wzh201998/ECCE_2026_Design-and-Implementation-of-A-Hybrid-EMI-Filter-for-11kW-OBC/Figure/Filter_Hardware.png

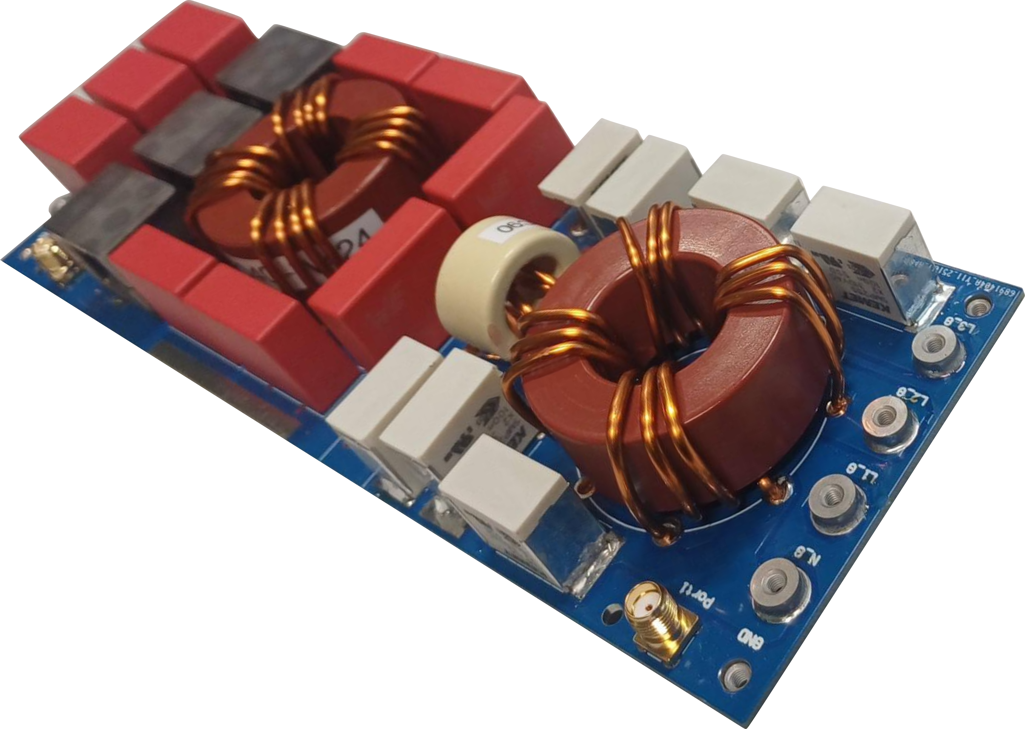
Figure/Filter_Hardware.png
