wzh201998/ECCE_2026_Design-and-Implementation-of-A-Hybrid-EMI-Filter-for-11kW-OBC/Experiment/Thermal/FLIR0065.jpg

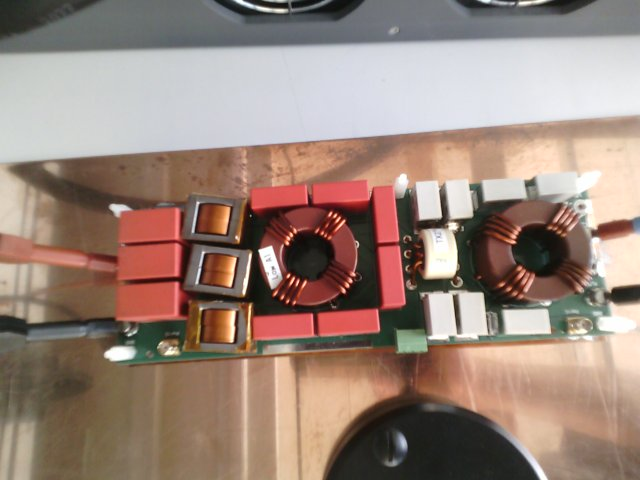
Experiment/Thermal/FLIR0065.jpg
