wzh201998/ECCE_2026_Design-and-Implementation-of-A-Hybrid-EMI-Filter-for-11kW-OBC/README.md

# ECCE_2026_Design-and-Implementation-of-A-Hybrid-EMI-Filter-for-11kW-OBC
ECCE 2026 paper "Design and Implementation of A Hybrid EMI Filter for 11kW OBC"
