wzh201998/ECCE_2026_Design-and-Implementation-of-A-Hybrid-EMI-Filter-for-11kW-OBC/Presentation/380_Hybrid EMI Filter for 11kW OBC.pptx

## Hybrid EMI Filter for 11kW Onboard Charger

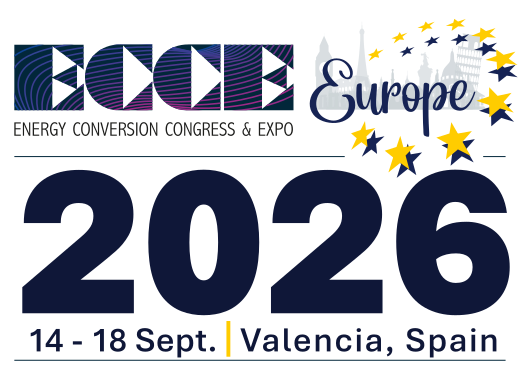
[picture p3: figure]

Weihao Zhao
Stefan Mollov
Michael Hartmann

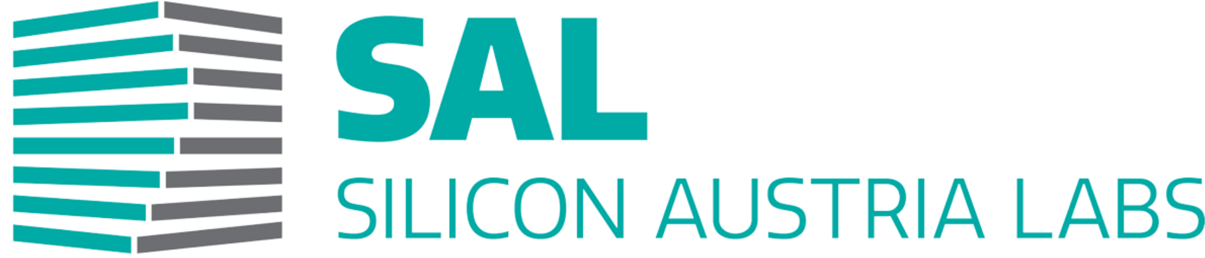
[picture p4: figure]

## Slide 2

Tiny Power Box Project

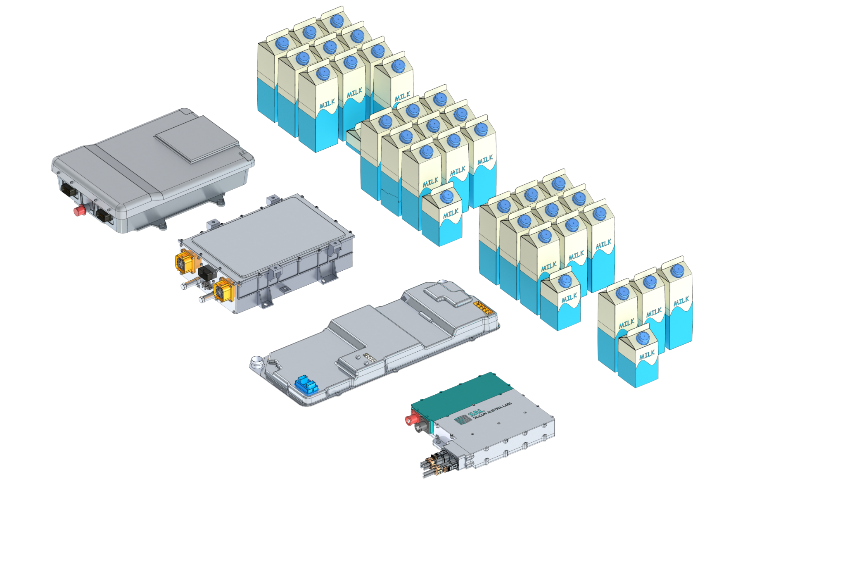
[picture p5: figure]

*Volume indicator

High-Power Density OBC
- 3Φ (11kW) /1Φ (7.2kW)
- IEC-61851 Compliant
- Low-Profile

2.0

## Slide 3

3-Φ/1-Φ Input EV Chargers

High-Power Density OBC
- 3Φ (11kW) /1Φ (7.2kW)
- IEC-61851 Compliant
- Low-Profile

Topology1

IEC-61851-21-1: Conductive charging systems for electric vehicles - Part 21-1: EMC requirements for on-board chargers for AC/DC powered electric vehicles

## Slide 4

Design Challenges

- 3Φ/1Φ Input Compatible

3Φ Mode

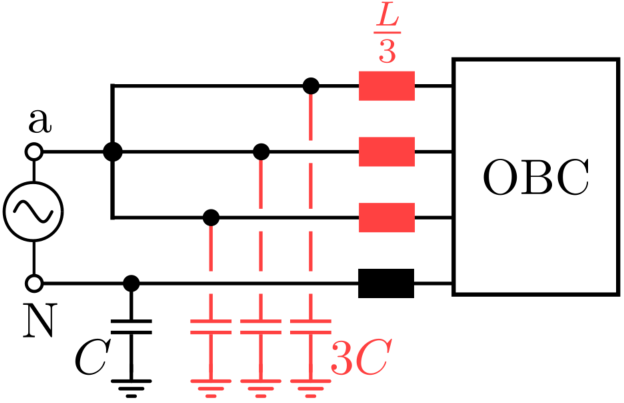
[picture p7: figure]

1Φ Mode

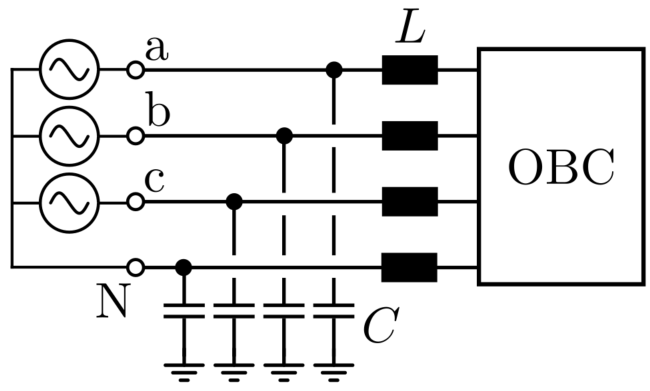
[picture p8: figure]

## Slide 5

Design Challenges

- 3Φ/1Φ Input Compatible
- Low Leakage Current[1]

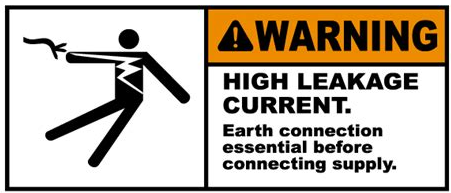
[picture p9: figure]
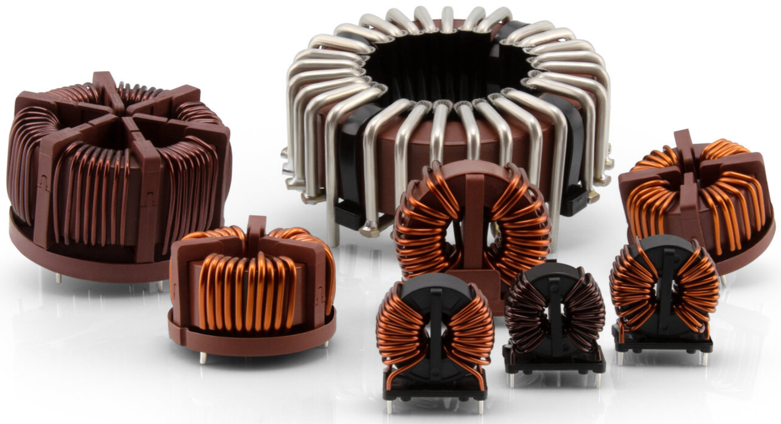
[picture p10: figure]

1. IEC 61851-1, Electric Vehicle Conductive Charging System-Part I General Requirements

## Slide 6

Design Challenges

- 3Φ/1Φ Input Compatible
- Low Leakage Current[1]
- Strict Volume Restriction

Z

Y

X

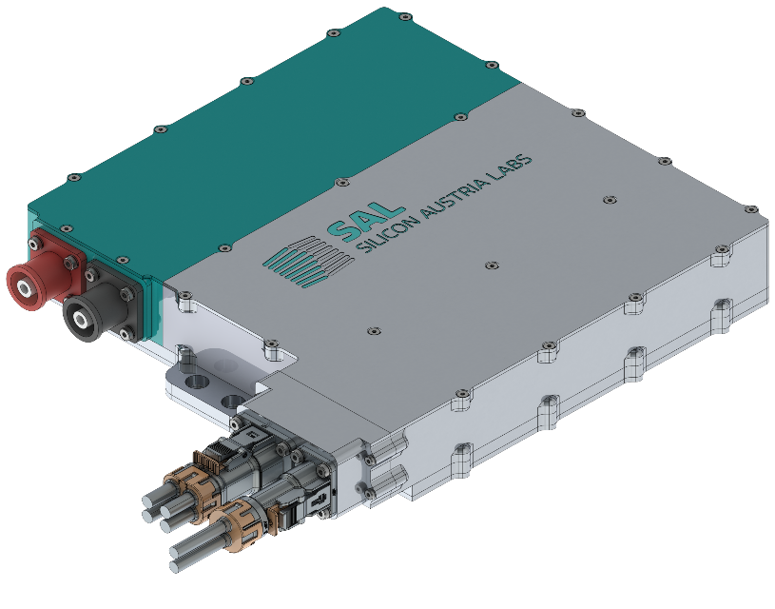
[picture p11: figure]

250mm

270mm

50mm

1. IEC 61851-1, Electric Vehicle Conductive Charging System-Part I General Requirements

## Slide 7

Solution

Passive EMI Filter

Hybrid EMI Filter

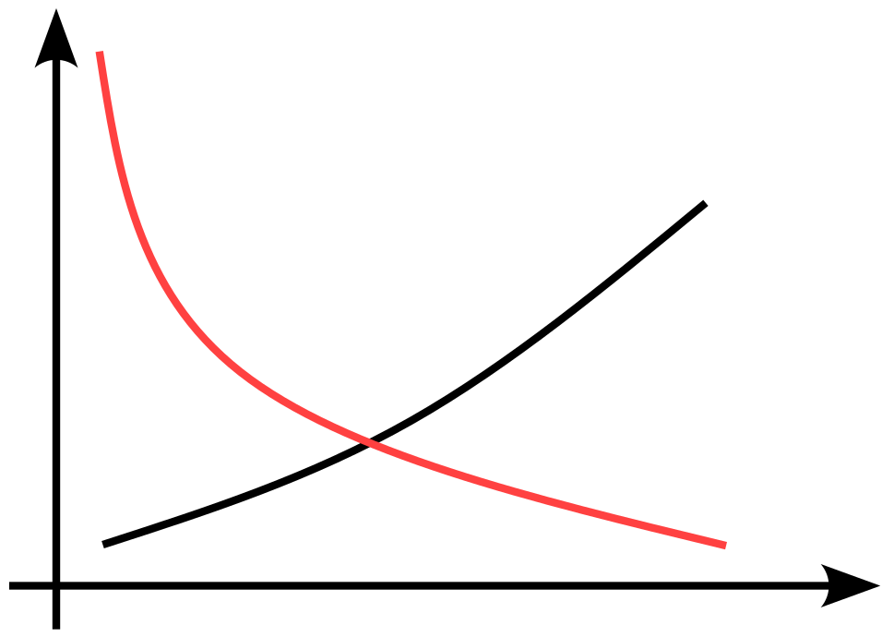
[picture p12: figure]
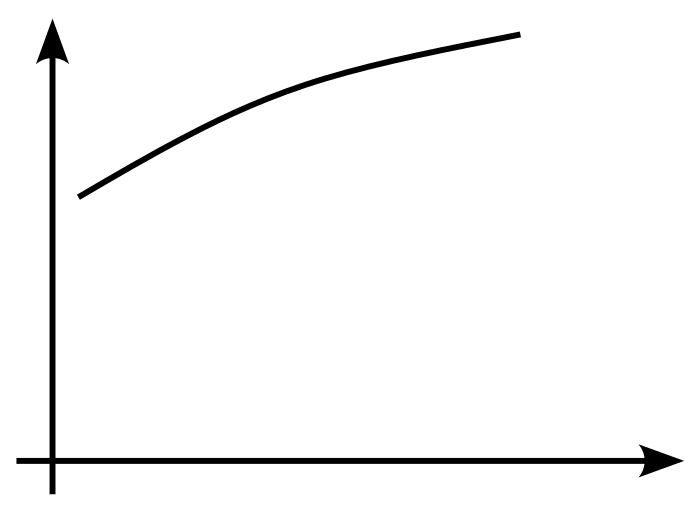
[picture p13: figure]

Passive Filter

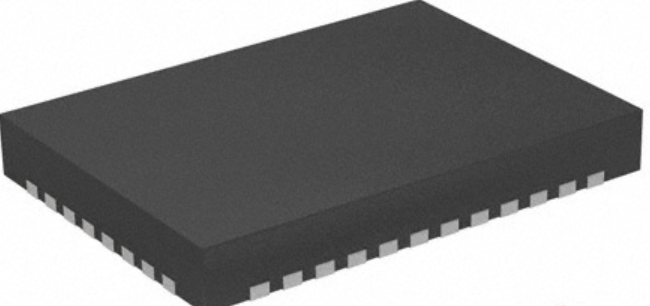
[picture p14: figure]

Active Filter

Attenuation (dB)

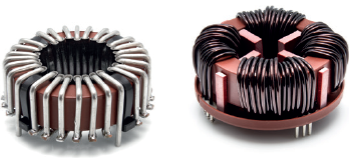
[picture p15: figure]

Attenuation (dB)

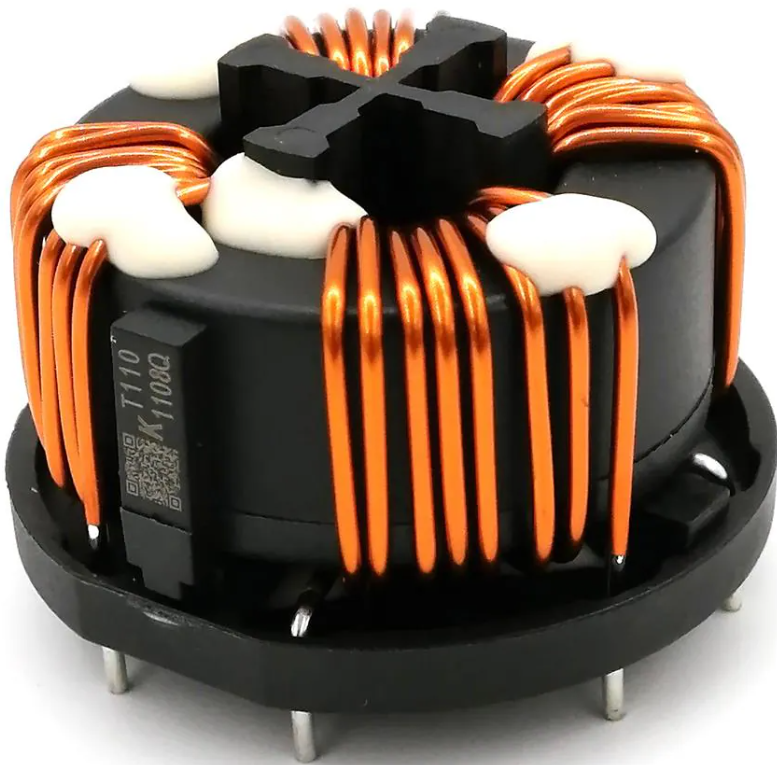
[picture p16: figure]

Passive Filter

Frequency

Frequency

https://vacuumschmelze.com/products/inductive-components-and-cores/amorphous-and-nanocrystalline-cores

## Slide 8

Active EMI Filter

  - Measurement
  - Processing
  - Compensation

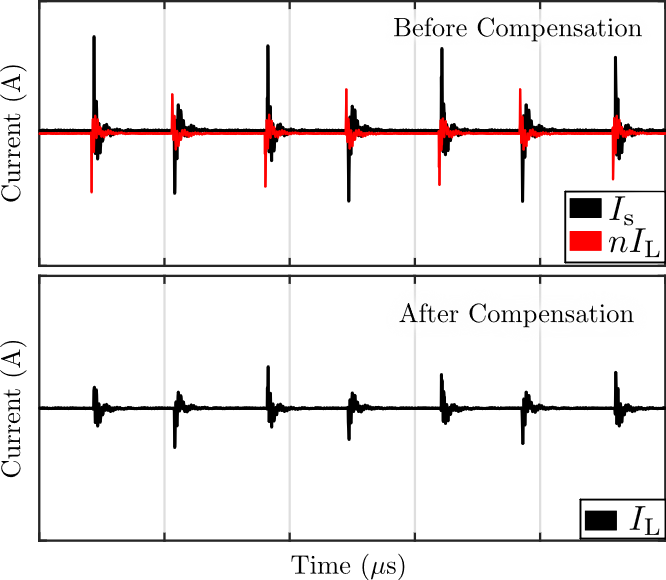
[picture p17: figure]

LISN

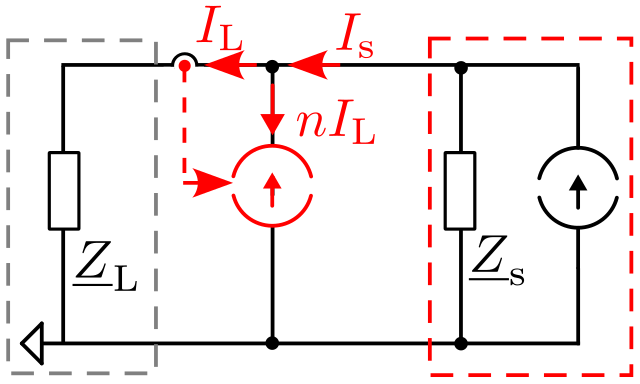
[picture p18: figure]

DUT

W. Zhao and M. Hartmann, "Design and Implementation of An Active Common Mode EMI Filter for LV Automotive Applications," PCIM 2025, Germany.

## Slide 9

Design Consideration

- Output Capability
- Stability
- Adaptability

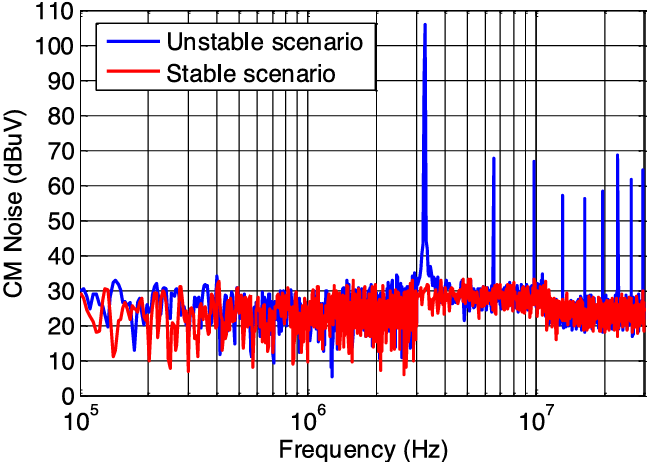
[picture p19: figure]
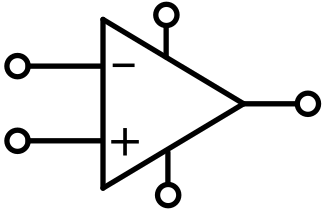
[picture p20: figure]

Y. Chu, S. Wang and Q. Wang, "Modeling and Stability Analysis of Active/Hybrid Common-Mode EMI Filters for DC/DC Power Converters," IEEE TPEL, 2016.

## Slide 10

Design Consideration

- Output Capability
- Stability
- Adaptability

~μA

~mA

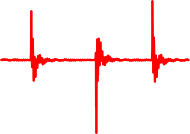
[picture p21: figure]

~ A

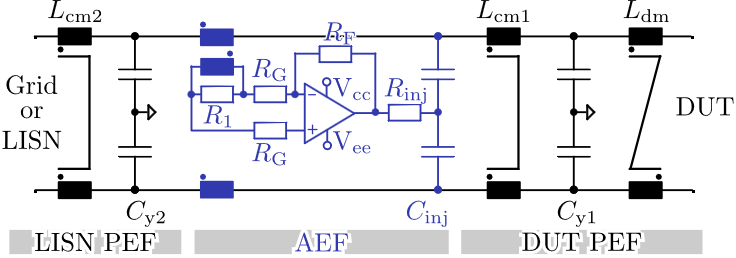
[picture p22: figure]

## Slide 11

11kW Hybrid Filter (3Φ Mode)

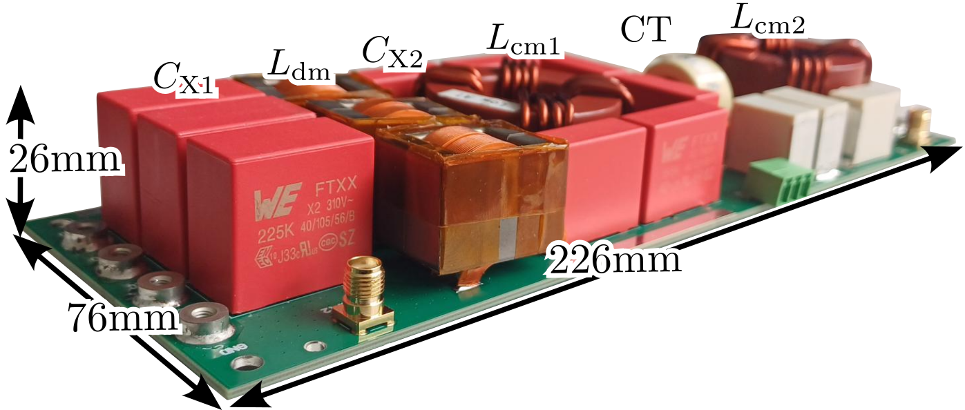
[picture p23: figure]

- 3Φ/1Φ Input Compatible
- 1.3mA Leakage Current

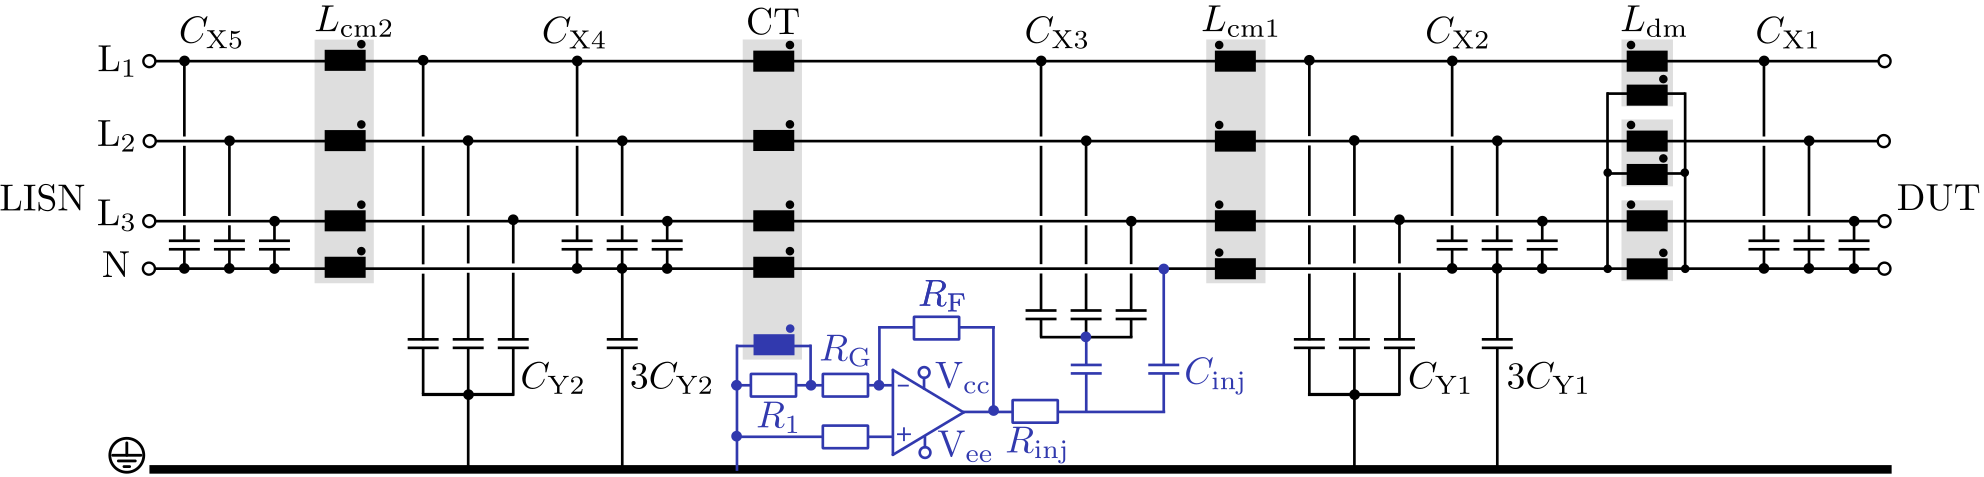
[picture p24: figure]

## Slide 12

11kW Hybrid Filter (1Φ Mode)

- 3Φ/1Φ Input Compatible
- 1.3mA Leakage Current

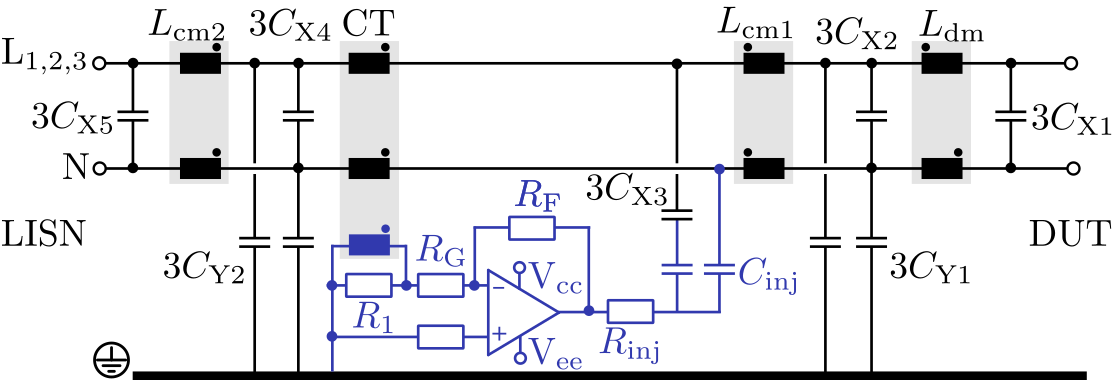
[picture p25: figure]

## Slide 13

Insertion Loss Measurement

- Effective 30kHz-2MHz
- 45dB improvement @450kHz

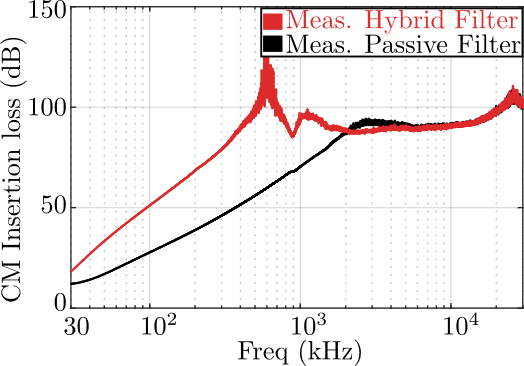
[picture p26: figure]
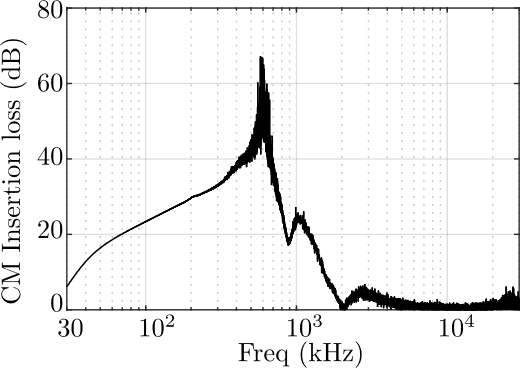
[picture p27: figure]

Active Filter

## Slide 14

Benchmark Passive Filter

- Lcm1 reduced by 90%
- Lcm2 reduced by 75%

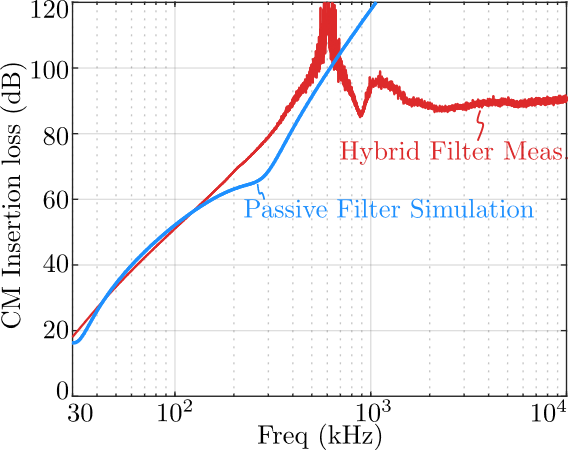
[picture p28: figure]
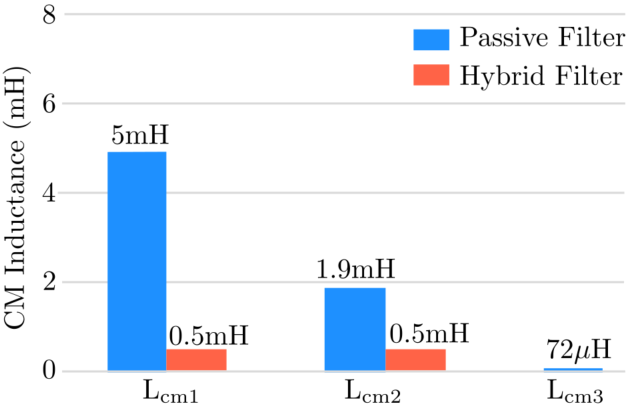
[picture p29: figure]

## Slide 15

Conductive Emission Measurement

- 50dB attenuation required

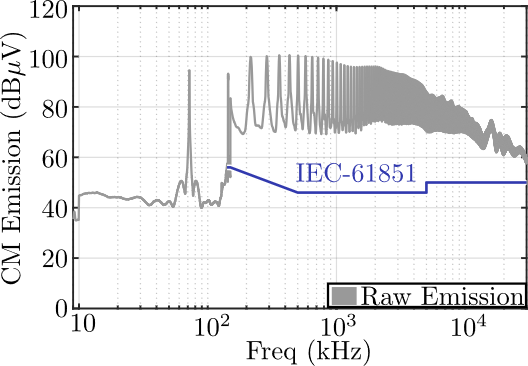
[picture p30: figure]

Copper Plane

LISN

DUT

EMI Receiver

## Slide 16

Conductive Emission Measurement

- 10dB violation in 150kHz-600kHz
- HF Noise is reduced

Copper Plane

LISN

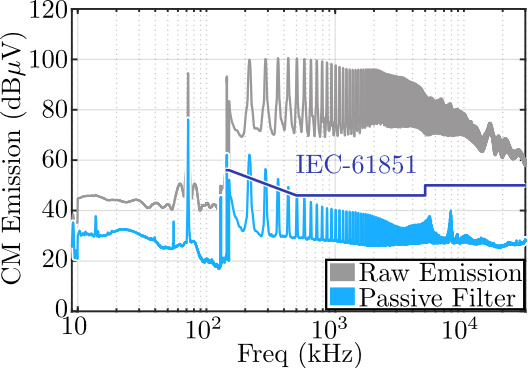
[picture p31: figure]

PEF

DUT

EMI Receiver

*PEF: Passive EMI Filter

## Slide 17

Conductive Emission Measurement

- Effective 9kHz-1MHz
- 27dB@150kHz

Copper Plane

LISN

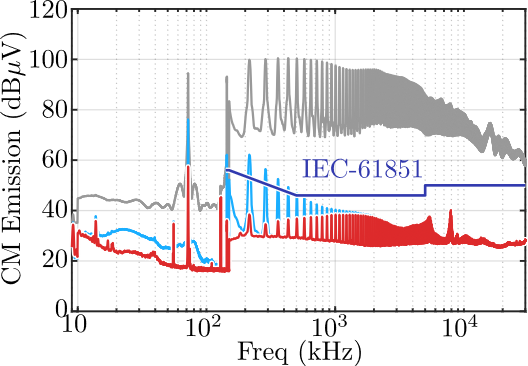
[picture p32: figure]

HEF

DUT

EMI Receiver

*HEF: Hybrid EMI Filter

## Slide 18

Conclusion

- Hybrid EMI Filter New Design Option
  - Volume/Weight Reduction
  - Higher Attenuation
  - Higher Power Density

Passive Filter

Hybrid Filter

https://vacuumschmelze.com/products/inductive-components-and-cores/amorphous-and-nanocrystalline-cores

## Slide 19

Questions

## Slide 20

Active EMI Filter Design

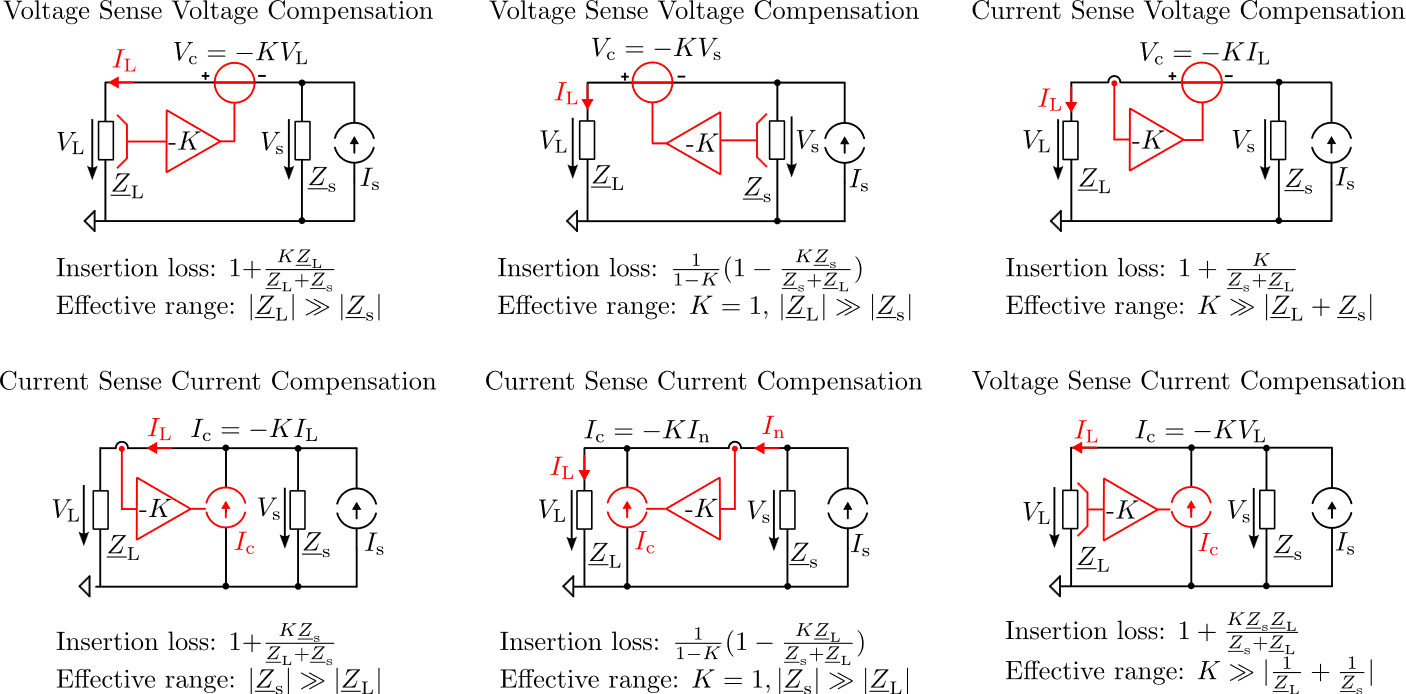
[picture p33: figure]

Notes: Top row, the compensation signal is voltage
Bottome row, the compensation signal is current

## Slide 21

Conclusion

3Φ /1Φ Comptible 11kW Hybrid EMI Filter
  - Inductance reduced by 90%
  - 27dB attenuation improvement @150kHz
  - Effective from 9kHz-1MHz
  - Low-Profile Filter Design (26mm)

Passive Filter

Hybrid Filter

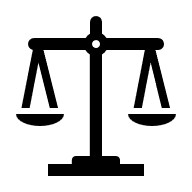
[picture p34: figure]
Scales of justice with solid fill

## Slide 22

Insertion Loss Measurement

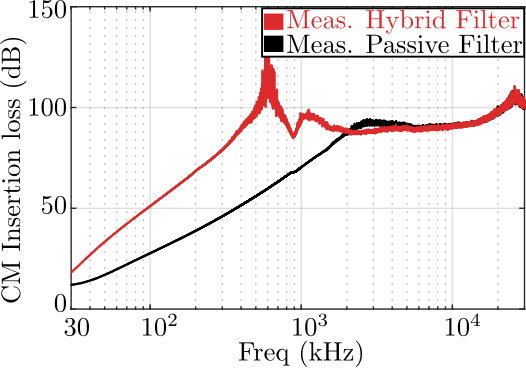
[picture p35: figure]

Vector Network Anlyzer

Hybrid Filter

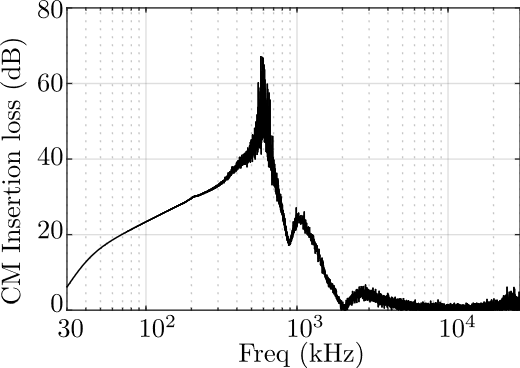
[picture p36: figure]
