wzh201998/ECCE_2026_Design-and-Implementation-of-A-Hybrid-EMI-Filter-for-11kW-OBC/Experiment/Meas_HEF_Spectrum/200v4a ldm1.BMP

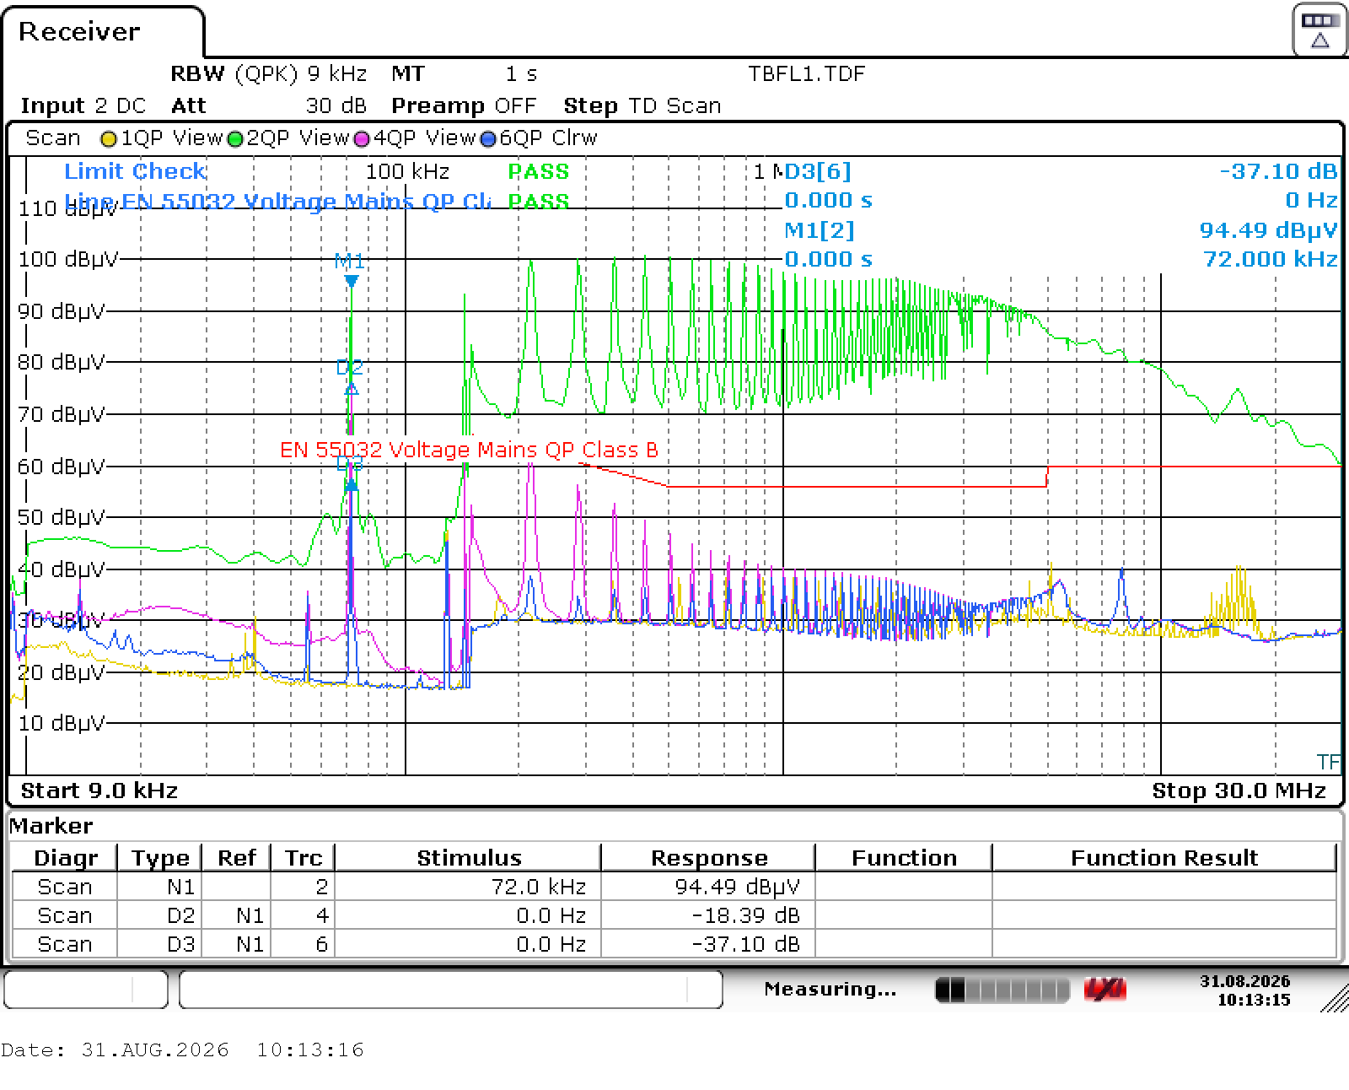
Experiment/Meas_HEF_Spectrum/200v4a ldm1.BMP
