wzh201998/ECCE_2026_Design-and-Implementation-of-A-Hybrid-EMI-Filter-for-11kW-OBC/Experiment/Cost_Analysis.xlsx

Capacitor
 | Part number | Units | Price(euro/1k)
CX1 | 890334026034 | 3 | 1.78376 | 5.35128 | 38.03209
CX2 | 890334026030CS | 3 | 1.455 | 4.365
CX3 | SMP255FC6100MD32TR32 | 7 | 2.52676 | 17.68732
Cy1 | DK1E3EA102M86RBH01 | 3 | 1.10723 | 3.32169
Cy2 | 8853522140011 | 6 | 0.73068 | 4.38408
Cinj | 8853522140011 | 4 | 0.73068 | 2.92272
Inductor
Lcm1 |  | 1 | 5.75 | 5.75 | 29.57452
Lcm2 |  | 1 | 5.75 | 5.75
CT | Tx22/14/!3 3C90 | 1 | 0.67452 | 0.67452
LDM |  | 6 | 2.9 | 17.4
AEF
OP-amp | LM7171 | 1 | 2.89229 | 2.89229 | 4.908292
power | TEC 3-2415 | 1 | 1.086002 | 1.086002
LDO | TPS7B8450QWDRBRQ1 | 1 | 0.93 | 0.93
PCB |  | 1 | 1.6 | 1.6
 |  |  |  | 74.114902
