wzh201998/ECCE_2026_Design-and-Implementation-of-A-Hybrid-EMI-Filter-for-11kW-OBC/Experiment/CM Choke/Large_AL/CM_choke_high_AL.pdf

# DPG10 Power Choke Tester

D.U.T.: | CM inductor-high AL

### Inspector:

Date: | 3/24/2026 3:32:22 PM
Parameters: | 1 A / 10 V / 1000 (35) µs
Resistance: | 2.22 mOhm

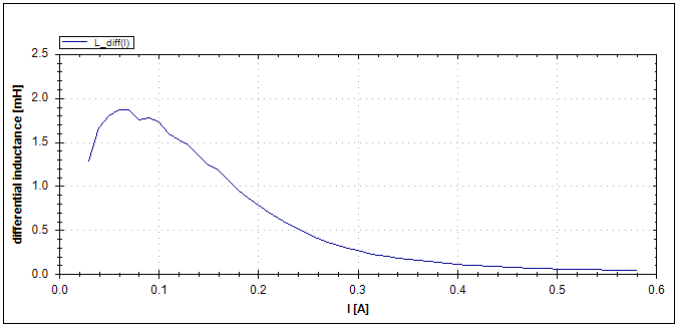
[picture p39: figure]

0.03 | 1.29
0.04 | 1.66
0.05 | 1.79
0.06 | 1.86
0.07 | 1.86
0.08 | 1.76
0.09 | 1.77
0.10 | 1.73
0.11 | 1.59
0.12 | 1.53
0.13 | 1.46
0.14 | 1.36
0.15 | 1.24
0.16 | 1.18
0.17 | 1.07
0.18 | 0.949
0.19 | 0.859
0.20 | 0.781
0.21 | 0.699
0.22 | 0.629
0.23 | 0.567
0.24 | 0.508
0.25 | 0.452
0.26 | 0.404
0.27 | 0.364
0.28 | 0.327
0.29 | 0.294
0.30 | 0.266
0.31 | 0.240
0.32 | 0.217
0.33 | 0.198
0.34 | 0.180
0.35 | 0.165
0.36 | 0.151
0.37 | 0.139
0.38 | 0.128
0.39 | 0.118
0.40 | 0.109
0.41 | 0.101
0.42 | 0.0945
0.43 | 0.0881
0.44 | 0.0824
0.45 | 0.0772
0.46 | 0.0725
0.47 | 0.0683
0.48 | 0.0644
0.49 | 0.0609
0.50 | 0.0576
0.51 | 0.0547
0.52 | 0.0519
0.53 | 0.0494
0.54 | 0.0471
0.55 | 0.0450
0.56 | 0.0430
0.57 | 0.0412
0.58 | 0.0395
