wzh201998/ECCE_2026_Design-and-Implementation-of-A-Hybrid-EMI-Filter-for-11kW-OBC/Experiment/CM Choke/Small_AL/CM_choke_low_AL.pdf

# DPG10 Power Choke Tester

D.U.T.: | CM inductor-high AL

### Inspector:

Date: | 3/24/2026 3:29:14 PM
Parameters: | 1 A / 10 V / 1000 (31) µs
Resistance: | 2.22 mOhm

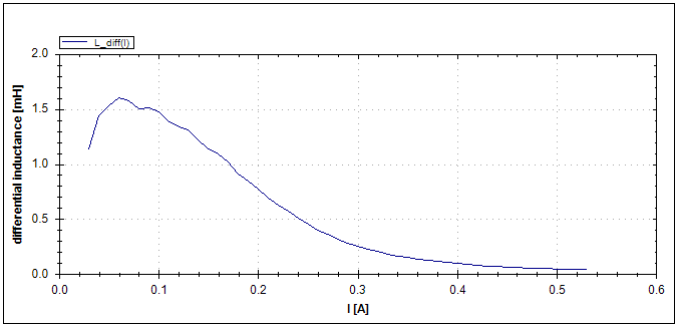
[picture p40: figure]

0.03 | 1.13
0.04 | 1.43
0.05 | 1.53
0.06 | 1.60
0.07 | 1.57
0.08 | 1.50
0.09 | 1.51
0.10 | 1.47
0.11 | 1.38
0.12 | 1.34
0.13 | 1.31
0.14 | 1.22
0.15 | 1.14
0.16 | 1.09
0.17 | 1.02
0.18 | 0.910
0.19 | 0.841
0.20 | 0.770
0.21 | 0.692
0.22 | 0.628
0.23 | 0.567
0.24 | 0.506
0.25 | 0.449
0.26 | 0.400
0.27 | 0.357
0.28 | 0.318
0.29 | 0.284
0.30 | 0.253
0.31 | 0.226
0.32 | 0.203
0.33 | 0.182
0.34 | 0.164
0.35 | 0.148
0.36 | 0.134
0.37 | 0.122
0.38 | 0.111
0.39 | 0.102
0.40 | 0.0930
0.41 | 0.0854
0.42 | 0.0787
0.43 | 0.0726
0.44 | 0.0673
0.45 | 0.0625
0.46 | 0.0582
0.47 | 0.0542
0.48 | 0.0507
0.49 | 0.0476
0.50 | 0.0447
0.51 | 0.0421
0.52 | 0.0398
0.53 | 0.0377
