wzh201998/ECCE_2026_Design-and-Implementation-of-A-Hybrid-EMI-Filter-for-11kW-OBC/Experiment/DM Inductor/Non_Coupled/DM_choke_non-coupled.pdf

# DPG10 Power Choke Tester

D.U.T.: | DM inductor-non coupled

### Inspector:

Date: | 3/24/2026 3:21:52 PM
Parameters: | 45 A / 10 V / 1000 (491) µs
Resistance: | 16.73 mOhm

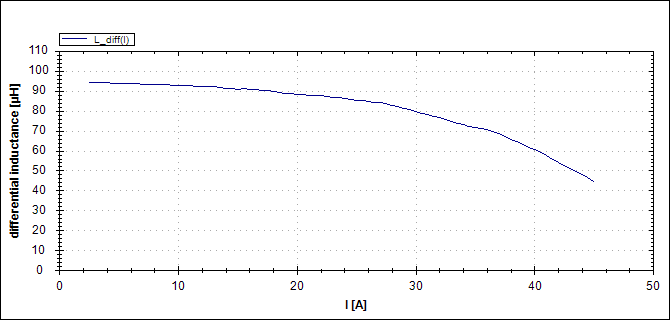
[picture p41: figure]

2.5 | 94.3
3.0 | 94.3
3.5 | 94.2
4.0 | 94.0
4.5 | 93.8
5.0 | 93.8
5.5 | 93.7
6.0 | 93.6
6.5 | 93.5
7.0 | 93.3
7.5 | 93.2
8.0 | 93.1
8.5 | 93.1
9.0 | 92.9
9.5 | 92.8
10.0 | 92.6
12.0 | 92.4
12.5 | 92.3
13.0 | 92.0
13.5 | 91.6
14.0 | 91.4
14.5 | 91.1
15.0 | 90.8
15.5 | 90.9
16.0 | 90.7
16.5 | 90.4
17.0 | 90.3
17.5 | 89.9
18.0 | 89.6
18.5 | 89.1
19.0 | 88.8
19.5 | 88.5
20.0 | 88.2
22.0 | 87.6
22.5 | 87.2
23.0 | 86.8
23.5 | 86.4
24.0 | 86.0
24.5 | 85.6
25.0 | 85.3
25.5 | 85.0
26.0 | 84.6
26.5 | 84.2
27.0 | 83.9
27.5 | 83.4
28.0 | 82.8
28.5 | 82.2
29.0 | 81.3
29.5 | 80.5
30.0 | 79.6
32.0 | 76.3
32.5 | 75.4
33.0 | 74.6
33.5 | 73.7
34.0 | 72.9
34.5 | 72.3
35.0 | 71.7
35.5 | 71.2
36.0 | 70.5
36.5 | 69.5
37.0 | 68.5
37.5 | 67.2
38.0 | 65.7
38.5 | 64.4
39.0 | 63.1
39.5 | 61.7
40.0 | 60.3
42.0 | 54.0
42.5 | 52.6
43.0 | 51.1
43.5 | 49.7
44.0 | 48.1
44.5 | 46.4
45.0 | 44.7
