wzh201998/ECCE_2026_Design-and-Implementation-of-A-Hybrid-EMI-Filter-for-11kW-OBC/Experiment/Insertion loss loop gain/loop_gain/LG_ZS-330pF_ZL_51ohm_RG_750_RF_330k.csv

! CMT | S5085 | 19027456 | 23.4.5/2
! Date: 5/5/2026 2:59:57 PM
! Stimulus(Hz) | S11(dB) | S21(dB) | S12(dB) | S22(dB) | S11(°) | S21(°) | S12(°) | S22(°)
9.00000000000E+03 | -1.15671814502E+00 | +1.87810815036E+00 | -3.32906641653E+01 | -3.68205466421E+00 | -3.84646780565E-01 | -6.38274167568E+01 | -1.17244611590E+02 | +1.42699971579E+02
9.00486835309E+03 | -1.12403581887E+00 | +1.99332080703E+00 | -3.31044346941E+01 | -3.69673923098E+00 | -5.13304897399E-01 | -6.41689890204E+01 | -1.19335589129E+02 | +1.43102283692E+02
9.00973933961E+03 | -1.07488799270E+00 | +2.06344917996E+00 | -3.34300378882E+01 | -3.76819387032E+00 | -3.76913345922E-01 | -6.37054117137E+01 | -1.20028874012E+02 | +1.42287006208E+02
9.01461296098E+03 | -1.21046187635E+00 | +1.92543281933E+00 | -3.28513662634E+01 | -3.59605288747E+00 | -6.28664895041E-01 | -6.47866442460E+01 | -1.31429012305E+02 | +1.42729907884E+02
9.01948921863E+03 | -1.20620292065E+00 | +1.90259607407E+00 | -3.14552883834E+01 | -3.67307805779E+00 | -5.94756830358E-01 | -6.43047218437E+01 | -1.17773229050E+02 | +1.43114495418E+02
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
