wzh201998/ECCE_2026_Design-and-Implementation-of-A-Hybrid-EMI-Filter-for-11kW-OBC/Experiment/Insertion loss loop gain/loop_gain/LG_ZS-330pF_ZL_51ohm_RG_750_RF_330k5.csv

! CMT | S5085 | 19027456 | 23.4.5/2
! Date: 5/5/2026 3:19:08 PM
! Stimulus(Hz) | S11(dB) | S21(dB) | S12(dB) | S22(dB) | S11(°) | S21(°) | S12(°) | S22(°)
9.00000000000E+03 | -1.16299261923E+00 | +2.12440108780E+00 | -5.05985279097E+01 | -3.97004784317E+00 | +9.59268277828E-02 | -6.35660774952E+01 | -1.24056308393E+02 | +1.40884515646E+02
9.00486835309E+03 | -1.15570165043E+00 | +2.12535143606E+00 | -4.94974490676E+01 | -3.95918776834E+00 | +3.45443943252E-01 | -6.33629180502E+01 | -1.10757747710E+02 | +1.40799848604E+02
9.00973933961E+03 | -1.15739405081E+00 | +2.13471309024E+00 | -4.84651830921E+01 | -3.97483042737E+00 | +3.13496101804E-01 | -6.32808011098E+01 | -1.23852575224E+02 | +1.40942857125E+02
9.01461296098E+03 | -1.19134033066E+00 | +2.11616762808E+00 | -4.94539242612E+01 | -3.97927985951E+00 | +4.48773737656E-01 | -6.33594766356E+01 | -1.11658414418E+02 | +1.40902847237E+02
9.01948921863E+03 | -1.18577257986E+00 | +2.12461317161E+00 | -5.03067275681E+01 | -3.95722743840E+00 | +2.11713205886E-01 | -6.36633047683E+01 | -1.26357148172E+02 | +1.40852617524E+02
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
