wzh201998/ECCE_2026_Design-and-Implementation-of-A-Hybrid-EMI-Filter-for-11kW-OBC/Experiment/CM Choke/Large_AL/CM_CHOKE_HIGH_AL.CSV

!Keysight Technologies | E4990A | MY54302543 | A.03.06
!Date: Tue Mar 24 14:52:03 2026
BEGIN CH1_DATA
DCV(V) | +1.851e-004 | DCI(A) | -2.556e-006
Frequency(Hz) | |Z|(Ohm)-data | theta-z(deg)-data | Ls(H)-data | Rs(Ohm)-data
+1.00000000000e+003 | +1.31805928802e+001 | +8.57486233890e+001 | +2.09198433187e-003 | +9.77109649249e-001
+1.00733600000e+003 | +1.32726217445e+001 | +8.57630723490e+001 | +2.09128860919e-003 | +9.80594037826e-001
+1.01472600000e+003 | +1.33675650828e+001 | +8.57518557284e+001 | +2.09087861714e-003 | +9.90218299571e-001
+1.02217100000e+003 | +1.34637157109e+001 | +8.57383547727e+001 | +2.09054281316e-003 | +1.00050456570e+000
+1.02967000000e+003 | +1.35607170275e+001 | +8.57242600873e+001 | +2.09023111554e-003 | +1.01103951205e+000
+1.03722400000e+003 | +1.36586767097e+001 | +8.57067681808e+001 | +2.08994977663e-003 | +1.02250126532e+000
+1.04483300000e+003 | +1.37575608270e+001 | +8.56898759566e+001 | +2.08970369568e-003 | +1.03394846817e+000
+1.05249800000e+003 | +1.38566941615e+001 | +8.56728935816e+001 | +2.08938648615e-003 | +1.04549426679e+000
+1.06022000000e+003 | +1.39560745159e+001 | +8.56559932008e+001 | +2.08899790394e-003 | +1.05709736800e+000
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
