wzh201998/ECCE_2026_Design-and-Implementation-of-A-Hybrid-EMI-Filter-for-11kW-OBC/Experiment/CM Choke/Small_AL/CM choke_low_AL.csv

Version=3.7.0.8
Date=3/24/2026 3:29:14 PM
Type=CM inductor-high AL
Inspector=
Remark=
IMax [A]=1
UMax [V]=10
TMax [µs]=1000
FrequencyCorrection [Hz]=0
Stackfactor [%]=0
P-Factor for L-values (diff-Method)=0
P-Factor for LSUdt-values (diff-Method)=0
P-Factor for SUdt-values (diff-Method)=0
P-Factor for L-values (amp-Method)=0
P-Factor for LSUdt-values (amp-Method)=0
P-Factor for SUdt-values (amp-Method)=0
P-Factor for L-values (3~-Method)=0
P-Factor for L-values (3~-diff-Method)=0
MeasCount=1
LowLimitI_diff=
UppLimitI_diff=
LowLimitI_amp=
UppLimitI_amp=
LowLimitSUdt_diff=
UppLimitSUdt_diff=
LowLimitSUdt_amp=
UppLimitSUdt_amp=
LowLimitI_3~L1
UppLimitI_3~L1
LowLimitI_3~L2
UppLimitI_3~L2
LowLimitI_3~L3
UppLimitI_3~L3
LowLimitI_3~L_diff1
UppLimitI_3~L_diff1
LowLimitI_3~L_diff2
UppLimitI_3~L_diff2
LowLimitI_3~L_diff3
UppLimitI_3~L_diff3
Serialpoints=
Divisor for LI_diff-values=1000
Divisor for LI_amp-values=1000
Divisor for LSUdt_diff-values=1000
Divisor for LSUdt_amp-values=1000
Divisor for SUdt_diff-values=1000000
Divisor for SUdt_amp-values=1000000
DigitsI_diff=2
DigitsSUdt_diff=0
DigitsI_amp=2
DigitsSUdt_amp=0
Ohmic resistance[Ohm]=2.22m
Serial-No.=1181
Ix=1
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
