wzh201998/ECCE_2026_Design-and-Implementation-of-A-Hybrid-EMI-Filter-for-11kW-OBC/Experiment/CM Choke/Small_AL/CM_CHOKE_LOW_AL.CSV

!Keysight Technologies | E4990A | MY54302543 | A.03.06
!Date: Tue Mar 24 14:54:32 2026
BEGIN CH1_DATA
DCV(V) | +4.164e-005 | DCI(A) | -3.882e-007
Frequency(Hz) | |Z|(Ohm)-data | theta-z(deg)-data | Ls(H)-data | Rs(Ohm)-data
+1.00000000000e+003 | +1.14099703715e+001 | +8.67590780131e+001 | +1.81304882318e-003 | +6.45058116213e-001
+1.00733600000e+003 | +1.14932208012e+001 | +8.67761975682e+001 | +1.81300794086e-003 | +6.46336020036e-001
+1.01472600000e+003 | +1.15765533460e+001 | +8.67678537982e+001 | +1.81283898972e-003 | +6.52705507981e-001
+1.02217100000e+003 | +1.16603731327e+001 | +8.67563102462e+001 | +1.81264470526e-003 | +6.59776908131e-001
+1.02967000000e+003 | +1.17453763330e+001 | +8.67448069620e+001 | +1.81254050600e-003 | +6.66940959787e-001
+1.03722400000e+003 | +1.18311577303e+001 | +8.67306899990e+001 | +1.81245583102e-003 | +6.74722234054e-001
+1.04483300000e+003 | +1.19174479443e+001 | +8.67150597084e+001 | +1.81235113259e-003 | +6.82889065331e-001
+1.05249800000e+003 | +1.20043311560e+001 | +8.66995500316e+001 | +1.81224072464e-003 | +6.91111761127e-001
+1.06022000000e+003 | +1.20910645644e+001 | +8.66849747441e+001 | +1.81201321206e-003 | +6.99175847915e-001
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
