wzh201998/ECCE_2026_Design-and-Implementation-of-A-Hybrid-EMI-Filter-for-11kW-OBC/Experiment/DM Inductor/Coupled/DM_WINDING1.CSV

!Keysight Technologies | E4990A | MY54302543 | A.03.06
!Date: Tue Mar 24 14:05:22 2026
BEGIN CH1_DATA
DCV(V) | +3.442e-004 | DCI(A) | +3.352e-006
Frequency(Hz) | |Z|(Ohm)-data | theta-z(deg)-data | Ls(H)-data | Rs(Ohm)-data
+1.00000000000e+003 | +1.59441894503e-001 | +8.74513796204e+001 | +2.53508649359e-005 | +7.08992657557e-003
+1.00733600000e+003 | +1.61118615719e-001 | +8.75779074494e+001 | +2.54333360961e-005 | +6.80901772784e-003
+1.01472600000e+003 | +1.62855173843e-001 | +8.76654268559e+001 | +2.55218580272e-005 | +6.63385897443e-003
+1.02217100000e+003 | +1.64740788667e-001 | +8.77224654188e+001 | +2.56303485428e-005 | +6.54680055698e-003
+1.02967000000e+003 | +1.66606979272e-001 | +8.76941482663e+001 | +2.57314030734e-005 | +6.70323889085e-003
+1.03722400000e+003 | +1.69189032385e-001 | +8.75356257005e+001 | +2.59368922669e-005 | +7.27482131510e-003
+1.04483300000e+003 | +1.71314851042e-001 | +8.74217097995e+001 | +2.60692417130e-005 | +7.70650734192e-003
+1.05249800000e+003 | +1.73276356322e-001 | +8.72413436753e+001 | +2.61718591967e-005 | +8.33962387935e-003
+1.06022000000e+003 | +1.74945519330e-001 | +8.71163260659e+001 | +2.62286949240e-005 | +8.80122205039e-003
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
