wzh201998/ECCE_2026_Design-and-Implementation-of-A-Hybrid-EMI-Filter-for-11kW-OBC/Experiment/DM Inductor/Coupled/DM_WINDING2.CSV

!Keysight Technologies | E4990A | MY54302543 | A.03.06
!Date: Tue Mar 24 14:07:18 2026
BEGIN CH1_DATA
DCV(V) | -5.838e-005 | DCI(A) | +2.609e-006
Frequency(Hz) | |Z|(Ohm)-data | theta-z(deg)-data | Ls(H)-data | Rs(Ohm)-data
+1.00000000000e+003 | +1.56172890118e-001 | +8.73778522747e+001 | +2.48296625418e-005 | +7.14477502865e-003
+1.00733600000e+003 | +1.57904027802e-001 | +8.75037517161e+001 | +2.49245127192e-005 | +6.87734725750e-003
+1.01472600000e+003 | +1.59559365625e-001 | +8.76015468075e+001 | +2.50042031273e-005 | +6.67734891448e-003
+1.02217100000e+003 | +1.61530406855e-001 | +8.76320777259e+001 | +2.51292697650e-005 | +6.67383492945e-003
+1.02967000000e+003 | +1.63380032661e-001 | +8.76198964399e+001 | +2.52316834876e-005 | +6.78495994244e-003
+1.03722400000e+003 | +1.65836273914e-001 | +8.74448928705e+001 | +2.54211456012e-005 | +7.39302296013e-003
+1.04483300000e+003 | +1.68025709105e-001 | +8.73291371838e+001 | +2.55668343536e-005 | +7.82974086277e-003
+1.05249800000e+003 | +1.69910372133e-001 | +8.71926402839e+001 | +2.56623966758e-005 | +8.32188164421e-003
+1.06022000000e+003 | +1.71487303821e-001 | +8.70385641499e+001 | +2.57084408406e-005 | +8.85968499046e-003
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
