wzh201998/ECCE_2026_Design-and-Implementation-of-A-Hybrid-EMI-Filter-for-11kW-OBC/Experiment/DM Inductor/Non_Coupled/DM_WINDING_NONCOUPLED.CSV

!Keysight Technologies | E4990A | MY54302543 | A.03.06
!Date: Tue Mar 24 14:29:15 2026
BEGIN CH1_DATA
DCV(V) | +2.506e-004 | DCI(A) | +4.021e-006
Frequency(Hz) | |Z|(Ohm)-data | theta-z(deg)-data | Ls(H)-data | Rs(Ohm)-data
+1.00000000000e+003 | +6.25554511645e-001 | +8.82032516478e+001 | +9.95111431238e-005 | +1.96136580966e-002
+1.00733600000e+003 | +6.30832427814e-001 | +8.82495427274e+001 | +9.96224170980e-005 | +1.92697166999e-002
+1.01472600000e+003 | +6.36053787704e-001 | +8.82845138576e+001 | +9.97172962358e-005 | +1.90411658317e-002
+1.02217100000e+003 | +6.41330995310e-001 | +8.83012524261e+001 | +9.98131806818e-005 | +1.90118691845e-002
+1.02967000000e+003 | +6.46661336692e-001 | +8.83020751741e+001 | +9.99098350420e-005 | +1.91606021690e-002
+1.03722400000e+003 | +6.52710688601e-001 | +8.82764613490e+001 | +1.00108689140e-004 | +1.96315060884e-002
+1.04483300000e+003 | +6.58427470664e-001 | +8.82400433044e+001 | +1.00248128628e-004 | +2.02217619704e-002
+1.05249800000e+003 | +6.63962723896e-001 | +8.82018288665e+001 | +1.00352601346e-004 | +2.08343900850e-002
+1.06022000000e+003 | +6.69277619254e-001 | +8.81794991164e+001 | +1.00417910249e-004 | +2.12618713708e-002
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
