wzh201998/ECCE_2026_Design-and-Implementation-of-A-Hybrid-EMI-Filter-for-11kW-OBC/Experiment/IL_MEAS/HEF_CM1_50ohm.csv

! CMT | S5085 | 19027456 | 23.4.5/2
! Date: 4/10/2026 2:31:15 PM
! Stimulus(Hz) | S11(dB) | S21(dB) | S12(dB) | S22(dB) | S11(°) | S21(°) | S12(°) | S22(°)
9.00000000000E+03 | -3.75363820523E+00 | -4.07113490326E+00 | -8.44131345461E+00 | -5.00917188620E-01 | -5.66499894131E-01 | -7.49929516833E+01 | -2.63413238211E+01 | +3.05799458477E+01
9.24781195299E+03 | -3.85850329681E+00 | -4.12762728713E+00 | -8.37627681112E+00 | -3.70491056022E-01 | -1.77451479471E+00 | -7.67188364797E+01 | -2.47545732123E+01 | +2.98355012852E+01
9.49562390598E+03 | -3.97346161123E+00 | -4.19364037338E+00 | -8.27493327343E+00 | -2.39854720585E-01 | -2.92758756249E+00 | -7.84390644506E+01 | -2.32743173018E+01 | +2.90881994350E+01
9.74343585896E+03 | -4.09798607171E+00 | -4.25446725122E+00 | -8.14487817858E+00 | -1.12524745882E-01 | -3.98888826939E+00 | -8.02153632437E+01 | -2.19311465799E+01 | +2.83168491233E+01
9.99124781195E+03 | -4.23473565859E+00 | -4.31968714922E+00 | -7.98442570280E+00 | +1.46127532205E-02 | -5.03331952299E+00 | -8.19930218067E+01 | -2.07553923088E+01 | +2.75435278077E+01
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
