wzh201998/ECCE_2026_Design-and-Implementation-of-A-Hybrid-EMI-Filter-for-11kW-OBC/Experiment/IL_MEAS/PEF_CM1_50ohm.csv

! CMT | S5085 | 19027456 | 23.4.5/2
! Date: 4/10/2026 2:03:02 PM
! Stimulus(Hz) | S11(dB) | S21(dB) | S12(dB) | S22(dB) | S11(°) | S21(°) | S12(°) | S22(°)
9.00000000000E+03 | -2.07788225293E+00 | -6.98224073647E+00 | -6.97895501673E+00 | -2.04632132729E+00 | +1.86476231118E+01 | -5.56693722686E+01 | -5.57014463889E+01 | +2.20729113740E+01
9.24781195299E+03 | -2.04054841238E+00 | -7.13098587229E+00 | -7.13510572853E+00 | -2.00909623047E+00 | +1.79394081018E+01 | -5.60740014433E+01 | -5.61004558987E+01 | +2.14278389604E+01
9.49562390598E+03 | -2.00601849695E+00 | -7.27784748745E+00 | -7.27970749410E+00 | -1.97267972422E+00 | +1.72453956854E+01 | -5.64164545886E+01 | -5.64534824796E+01 | +2.08344744646E+01
9.74343585896E+03 | -1.97159307797E+00 | -7.41760194144E+00 | -7.42401819074E+00 | -1.93885019397E+00 | +1.65935456700E+01 | -5.67975239869E+01 | -5.68305040591E+01 | +2.02514622300E+01
9.99124781195E+03 | -1.94235599088E+00 | -7.55918411174E+00 | -7.56742978804E+00 | -1.90631513535E+00 | +1.59263943785E+01 | -5.71108991122E+01 | -5.71676968026E+01 | +1.97088363836E+01
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
