wzh201998/ECCE_2026_Design-and-Implementation-of-A-Hybrid-EMI-Filter-for-11kW-OBC/Experiment/IL_MEAS/PEF_DM1_50ohm.csv

! CMT | S5085 | 19027456 | 23.4.5/2
! Date: 4/10/2026 3:07:44 PM
! Stimulus(Hz) | S11(dB) | S21(dB) | S12(dB) | S22(dB) | S11(°) | S21(°) | S12(°) | S22(°)
9.00000000000E+03 | -3.80207003465E-01 | -1.49198734420E+01 | -1.49161072722E+01 | -4.85343830295E-01 | -1.65820207860E+02 | +1.14830787864E+02 | +1.15282888607E+02 | -1.57025325084E+02
9.24781195299E+03 | -3.09337756988E-01 | -1.69219135985E+01 | -1.68505062806E+01 | -3.20513946252E-01 | -1.67727541686E+02 | +1.11774845795E+02 | +1.11607825860E+02 | -1.60187237556E+02
9.49562390598E+03 | -2.73468857232E-01 | -1.86394515617E+01 | -1.85371096815E+01 | -2.74913021959E-01 | -1.68990354050E+02 | +1.10003820643E+02 | +1.09657349070E+02 | -1.62433977501E+02
9.74343585896E+03 | -2.31610804046E-01 | -2.01400633838E+01 | -2.00443549481E+01 | -2.30479884246E-01 | -1.69938777676E+02 | +1.08429535690E+02 | +1.07997077827E+02 | -1.64052736681E+02
9.99124781195E+03 | -2.20492710771E-01 | -2.15526034092E+01 | -2.14271896159E+01 | -1.89999744035E-01 | -1.70809052214E+02 | +1.07218793725E+02 | +1.06635054009E+02 | -1.65468572444E+02
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
