wzh201998/ECCE_2026_Design-and-Implementation-of-A-Hybrid-EMI-Filter-for-11kW-OBC/Experiment/IL_MEAS/PEF_DM_50ohm.csv

! CMT | S5085 | 19027456 | 23.4.5/2
! Date: 4/10/2026 3:03:34 PM
! Stimulus(Hz) | S11(dB) | S21(dB) | S12(dB) | S22(dB) | S11(°) | S21(°) | S12(°) | S22(°)
9.00000000000E+03 | -3.70677401507E-01 | -1.48279075474E+01 | -1.48060987771E+01 | -4.69506184523E-01 | -1.65708632225E+02 | +1.15331895273E+02 | +1.15139754595E+02 | -1.57153516537E+02
9.24781195299E+03 | -2.95023082205E-01 | -1.67597157105E+01 | -1.67245808407E+01 | -3.46901816093E-01 | -1.67465731114E+02 | +1.12475372181E+02 | +1.12172452240E+02 | -1.60257416686E+02
9.49562390598E+03 | -2.40051413636E-01 | -1.84511513222E+01 | -1.84019192626E+01 | -2.80048139478E-01 | -1.68802093933E+02 | +1.10404061217E+02 | +1.10048158519E+02 | -1.62491675564E+02
9.74343585896E+03 | -2.15302069037E-01 | -1.99725049959E+01 | -1.99044937948E+01 | -2.34941991244E-01 | -1.69768563059E+02 | +1.08973860619E+02 | +1.08528553827E+02 | -1.64188634966E+02
9.99124781195E+03 | -1.95193309636E-01 | -2.13466969195E+01 | -2.12615512080E+01 | -2.06574607082E-01 | -1.70632409664E+02 | +1.07812241443E+02 | +1.07262383764E+02 | -1.65603598129E+02
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
