wzh201998/ECCE_2026_Design-and-Implementation-of-A-Hybrid-EMI-Filter-for-11kW-OBC/Experiment/Insertion loss loop gain/HEF_CM_50ohm1.csv

! CMT | S5085 | 19027456 | 23.4.5/2
! Date: 9/2/2026 1:01:41 PM
! Stimulus(Hz) | S11(dB) | S21(dB) | S12(dB) | S22(dB) | S11(°) | S21(°) | S12(°) | S22(°)
9.00000000000E+03 | -3.64861369487E+00 | -4.33780287050E+00 | -8.45152879323E+00 | -4.98758916664E-01 | -1.73139650386E-01 | -7.42352134141E+01 | -2.68513801944E+01 | +2.95208979878E+01
9.24781195299E+03 | -3.73962685925E+00 | -4.38331423035E+00 | -8.37653447284E+00 | -3.72354290185E-01 | -1.39505535044E+00 | -7.59226341235E+01 | -2.53690455436E+01 | +2.87854014714E+01
9.49562390598E+03 | -3.83596552612E+00 | -4.45439554079E+00 | -8.27489887235E+00 | -2.56261938332E-01 | -2.51512794497E+00 | -7.75308247898E+01 | -2.39701518640E+01 | +2.80714925492E+01
9.74343585896E+03 | -3.96189117277E+00 | -4.51394674873E+00 | -8.14990863344E+00 | -1.31350739934E-01 | -3.54990114461E+00 | -7.93050576945E+01 | -2.27426168319E+01 | +2.73081686132E+01
9.99124781195E+03 | -4.08916473572E+00 | -4.56849962474E+00 | -7.99296600486E+00 | -4.66677011076E-03 | -4.55276273782E+00 | -8.09421929212E+01 | -2.16660775119E+01 | +2.65634831287E+01
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
