wzh201998/ECCE_2026_Design-and-Implementation-of-A-Hybrid-EMI-Filter-for-11kW-OBC/Experiment/CM Choke/Large_AL/1000000707.jpg

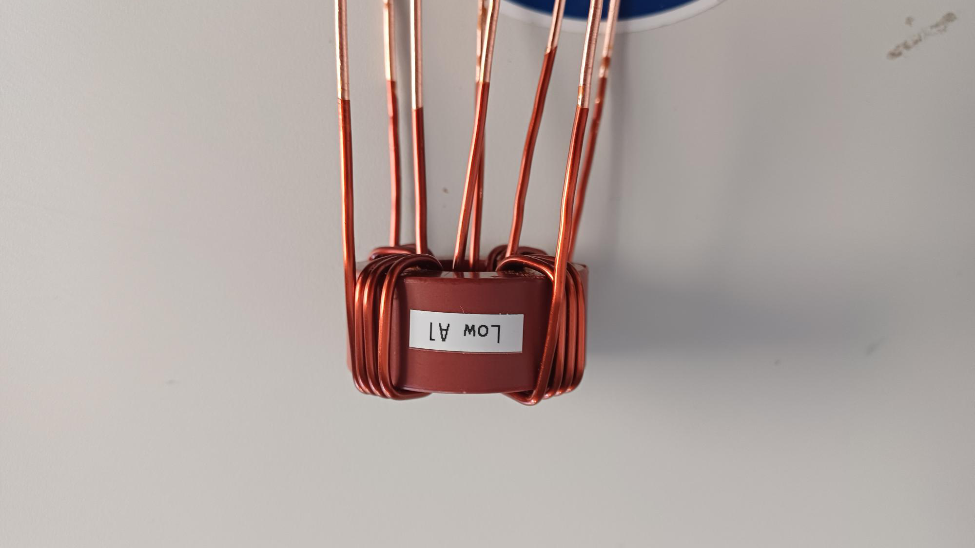
Experiment/CM Choke/Large_AL/1000000707.jpg
