wzh201998/ECCE_2026_Design-and-Implementation-of-A-Hybrid-EMI-Filter-for-11kW-OBC/Experiment/CM Choke/Small_AL/1000000708.jpg

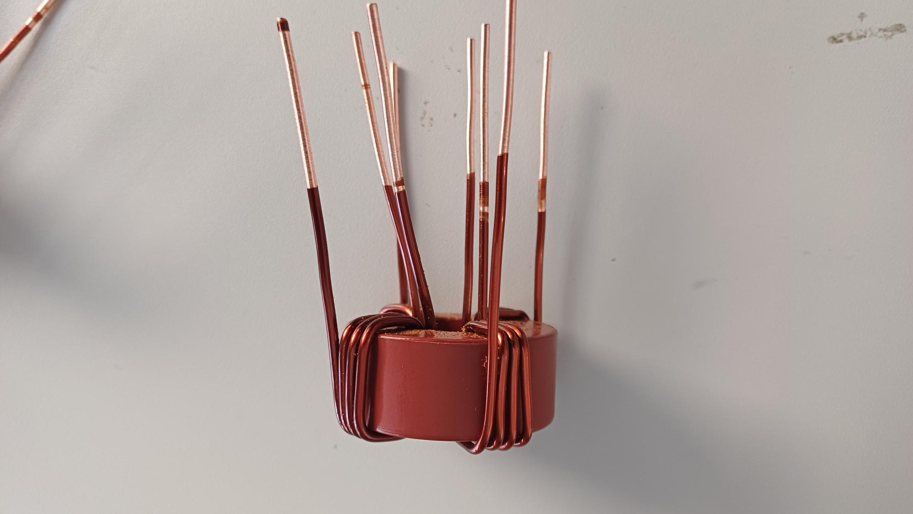
Experiment/CM Choke/Small_AL/1000000708.jpg
