wzh201998/ECCE_2026_Design-and-Implementation-of-A-Hybrid-EMI-Filter-for-11kW-OBC/Experiment/DM Inductor/1000000709.jpg

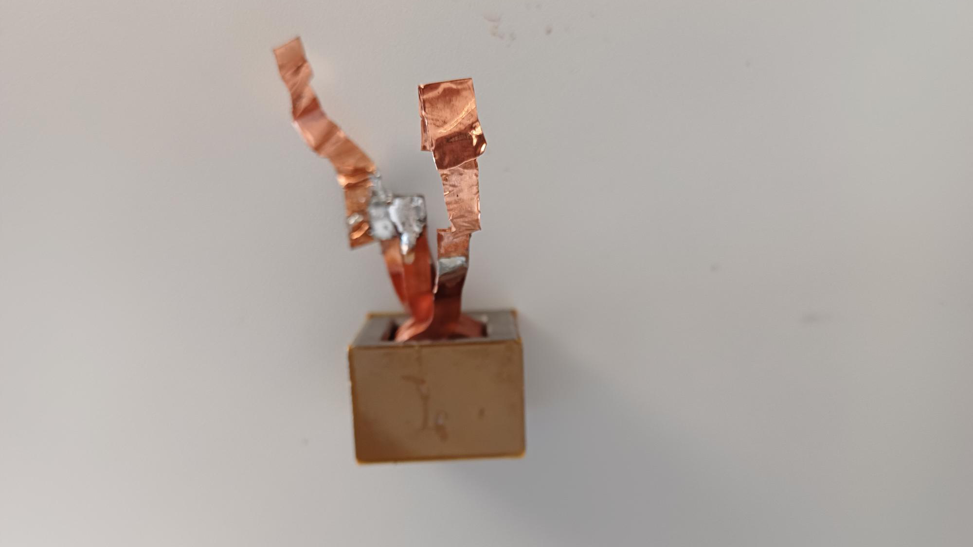
Experiment/DM Inductor/1000000709.jpg
