wzh201998/ECCE_2026_Design-and-Implementation-of-A-Hybrid-EMI-Filter-for-11kW-OBC/Experiment/DM Inductor/Coupled/DM_WINDING1.PNG

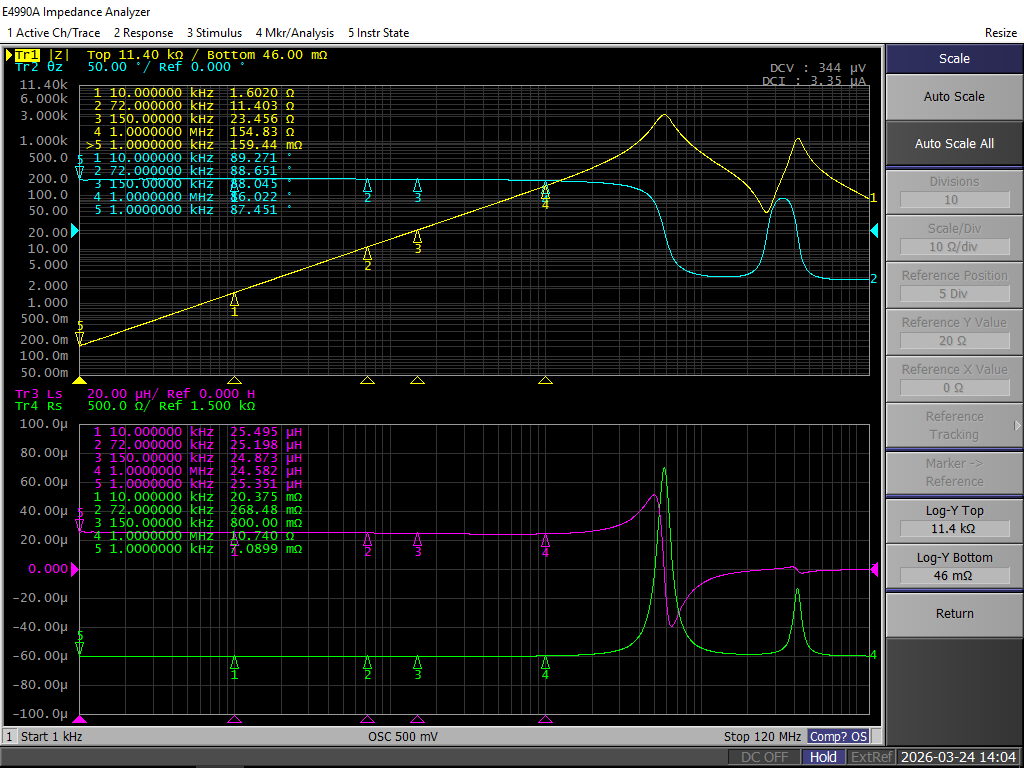
Experiment/DM Inductor/Coupled/DM_WINDING1.PNG
