wzh201998/ECCE_2026_Design-and-Implementation-of-A-Hybrid-EMI-Filter-for-11kW-OBC/Presentation/380_Hybrid EMI Filter for 11kW OBC.pdf

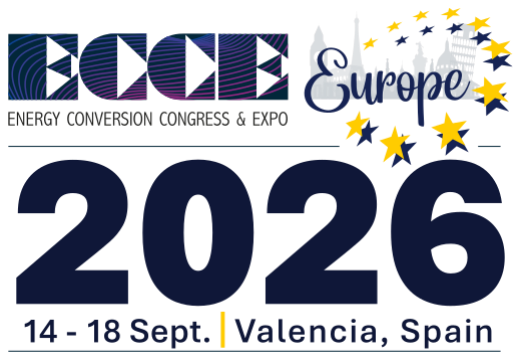
[picture p54: figure]

## Hybrid EMI Filter for 11kW Onboard Charger

Weihao Zhao

Stefan Mollov

Michael Hartmann

## Tiny Power Box Project

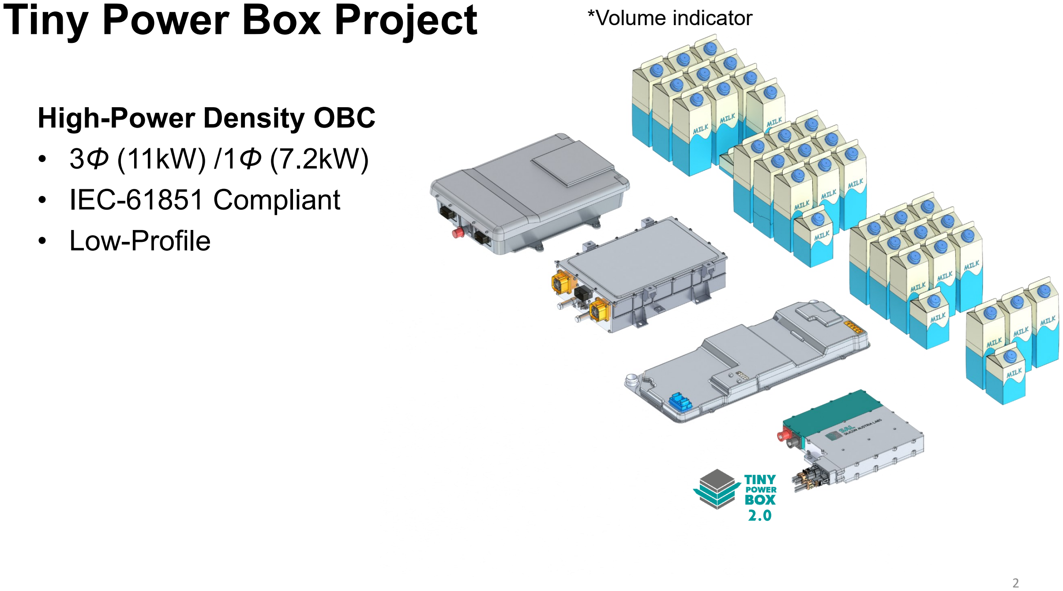
[picture p55: page 2]

2.0

High-Power Density OBC
- 3Φ (11kW) /1Φ (7.2kW)
- IEC-61851 Compliant
- Low-Profile

*Volume indicator

## 3-Φ/1-Φ Input EV Chargers

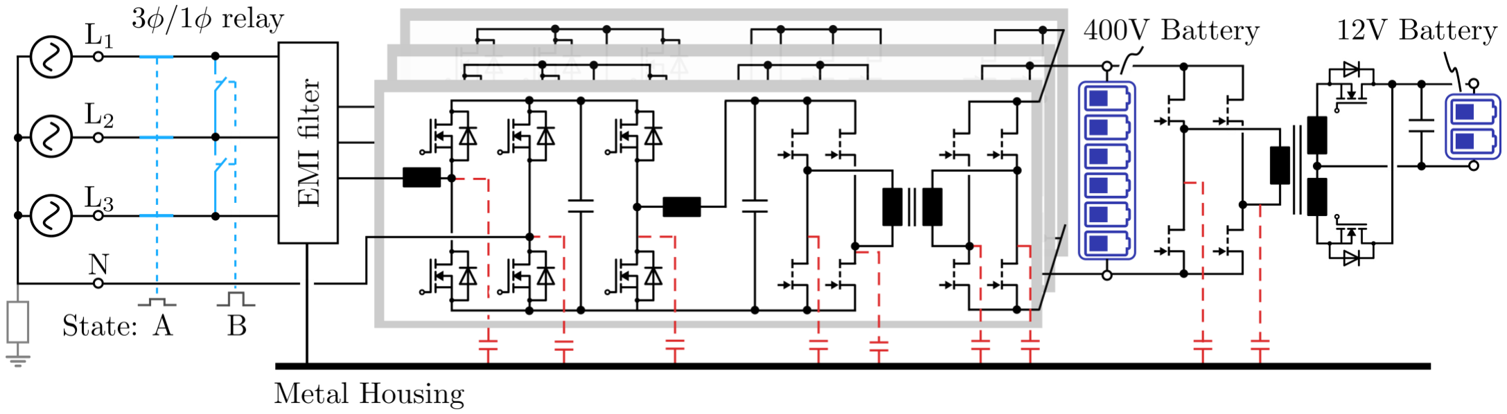
[picture p56: figure]
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

High-Power Density OBC
- 3Φ (11kW) /1Φ (7.2kW)
- IEC-61851 Compliant
- Low-Profile

## Design Challenges

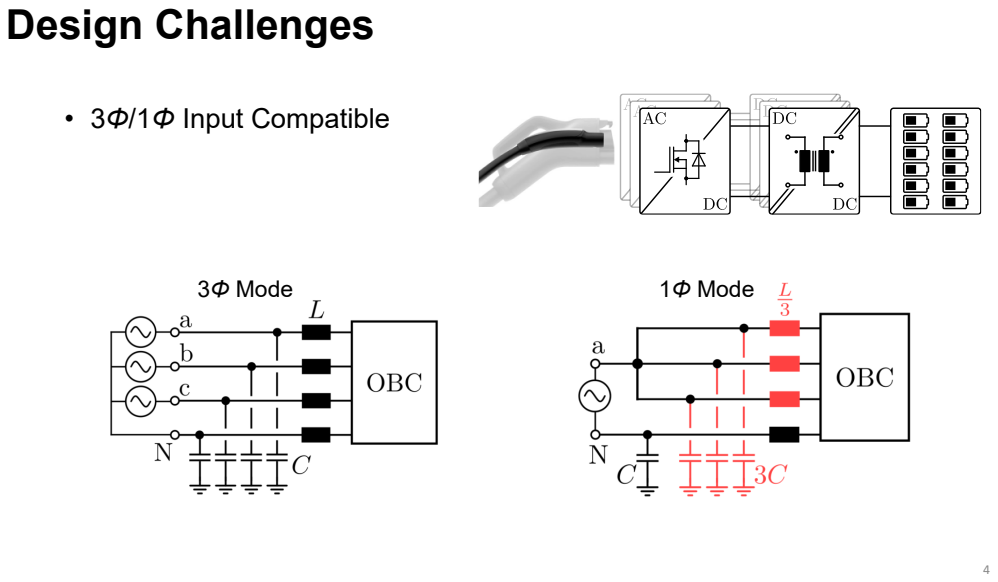
[picture p57: page 4]
• 3Φ/1Φ Input Compatible; 3Φ Mode; 1Φ Mode

## Design Challenges

- 3Φ/1Φ Input Compatible
- Low Leakage Current[1]

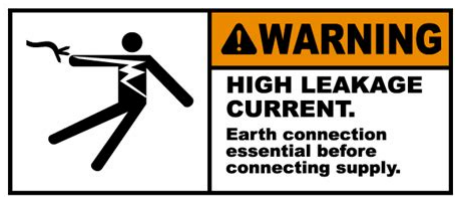
[picture p58: figure]

1. IEC 61851-1, Electric Vehicle Conductive Charging System-Part I General Requirements

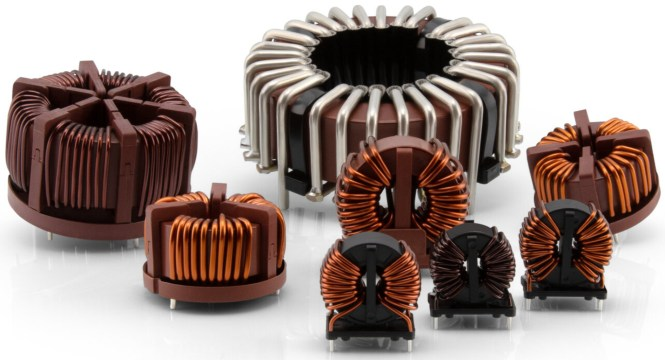
[picture p59: figure]

## Design Challenges

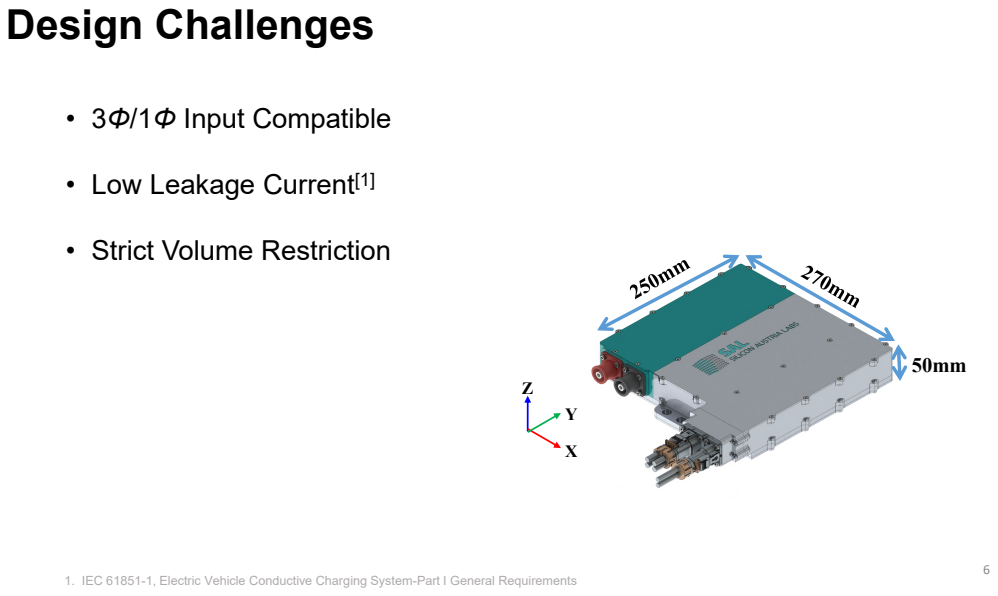
[picture p60: page 6]
• 3Φ/1Φ Input Compatible

• Low Leakage Current[1]

• Strict Volume Restriction

1. IEC 61851-1, Electric Vehicle Conductive Charging System-Part I General Requirements

## Solution

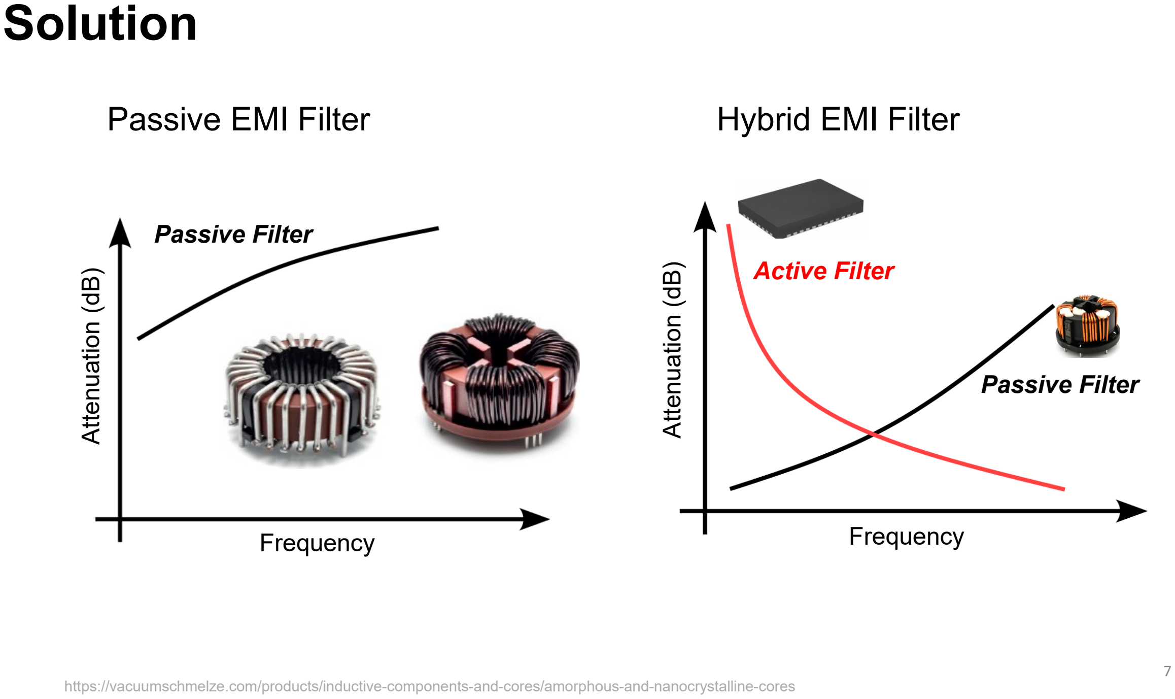
[picture p61: page 7]

Hybrid EMI Filter

Frequency

Attenuation (dB)

Frequency

Attenuation (dB)

Passive Filter

Passive Filter

Active Filter

Passive EMI Filter

https://vacuumschmelze.com/products/inductive-components-and-cores/amorphous-and-nanocrystalline-cores

## Active EMI Filter

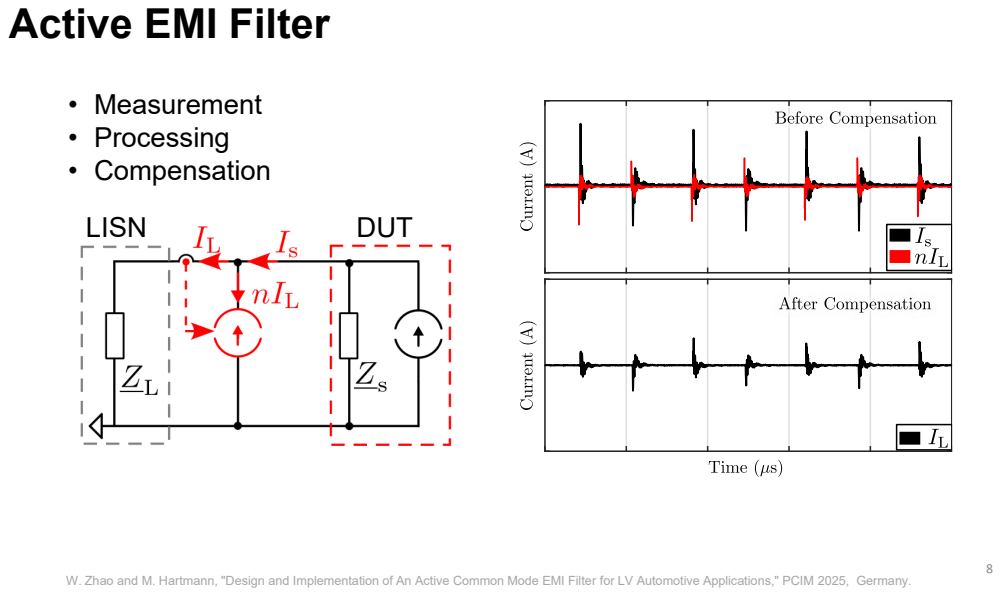
[picture p62: page 8]
• Measurement • Processing • Compensation; LISN; DUT

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

## Design Consideration

- Output Capability
- Stability
- Adaptability

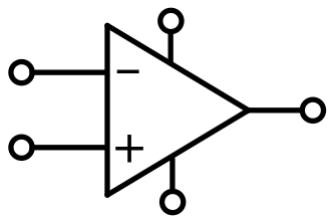
[picture p63: figure]
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

## Design Consideration

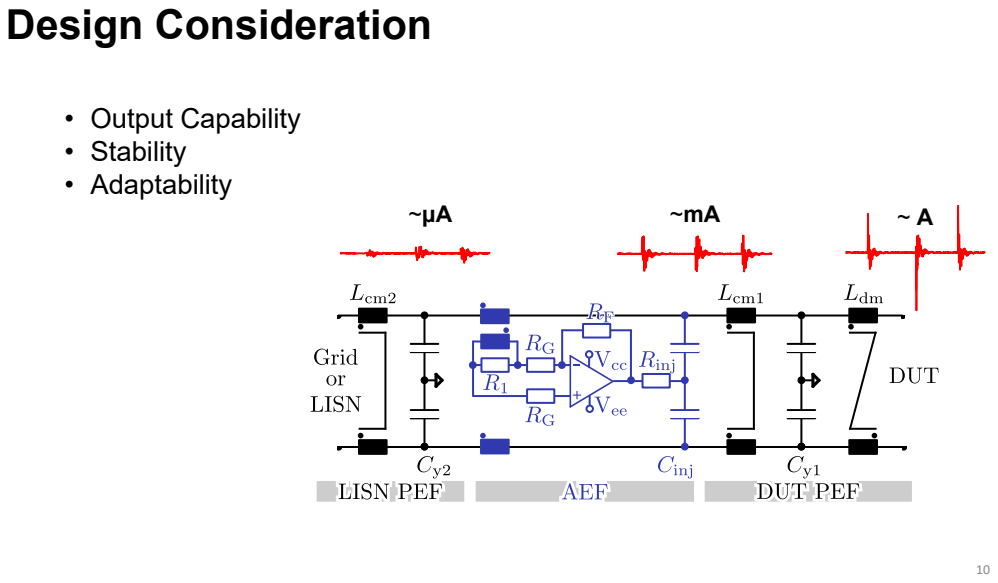
[picture p64: page 10]
• Output Capability • Stability • Adaptability

## 11kW Hybrid Filter (3Φ Mode)

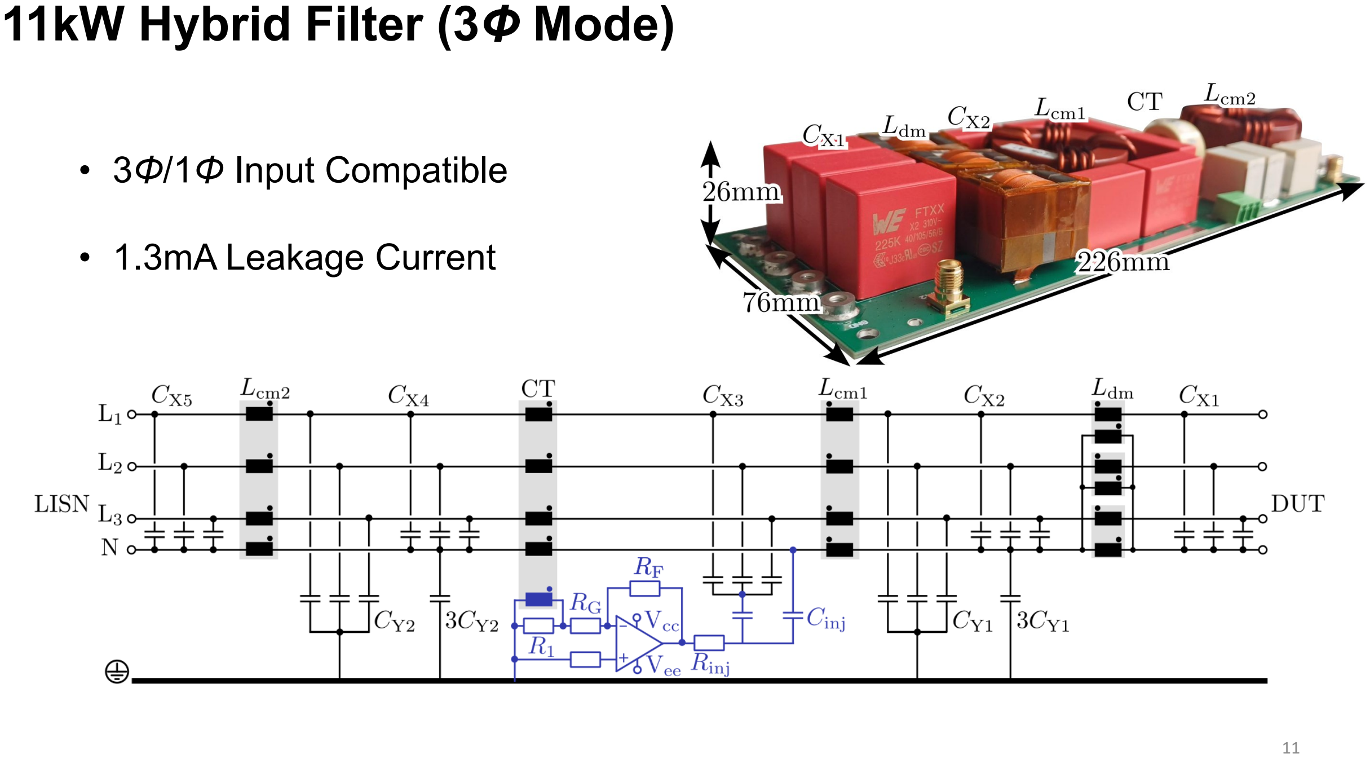
[picture p65: page 11]

- 3Φ/1Φ Input Compatible
- 1.3mA Leakage Current

## 11kW Hybrid Filter (1Φ Mode)

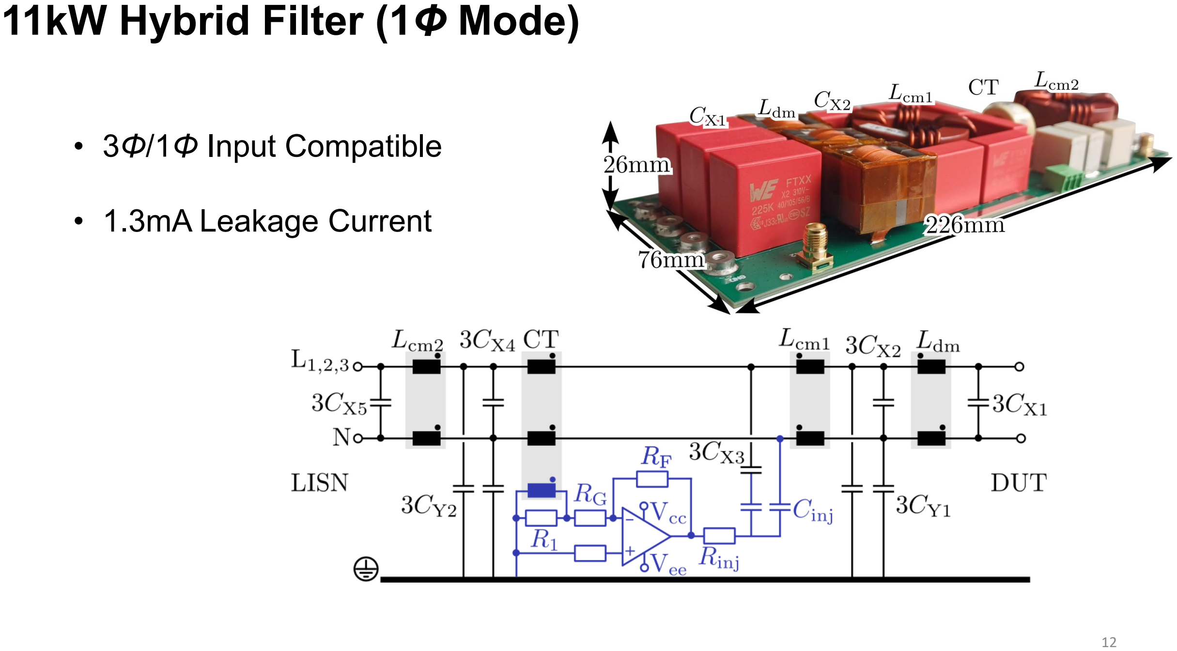
[picture p66: page 12]

- 3Φ/1Φ Input Compatible
- 1.3mA Leakage Current

## Insertion Loss Measurement

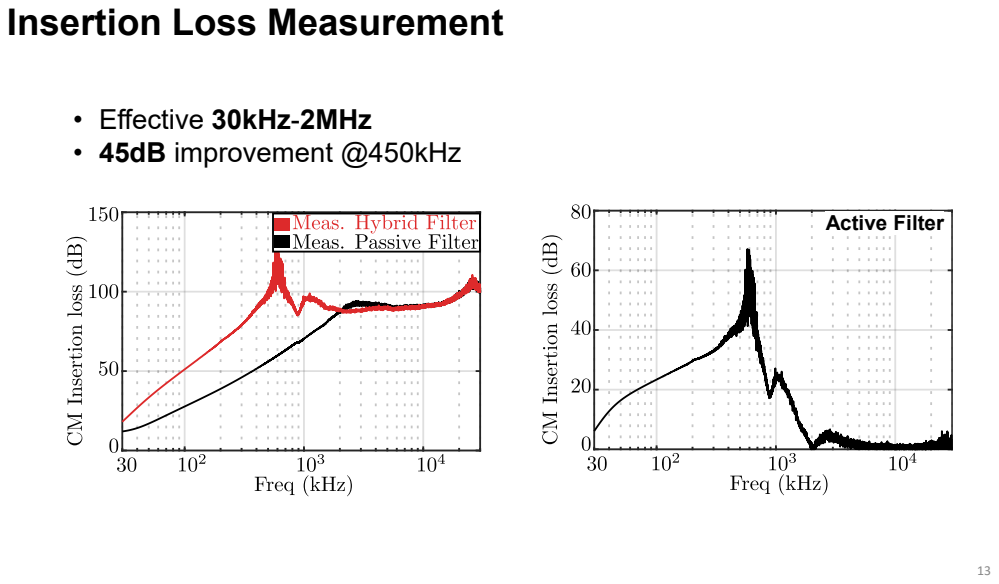
[picture p67: page 13]
• Effective 30kHz-2MHz • 45dB improvement @450kHz; Active; Filter

## Benchmark Passive Filter

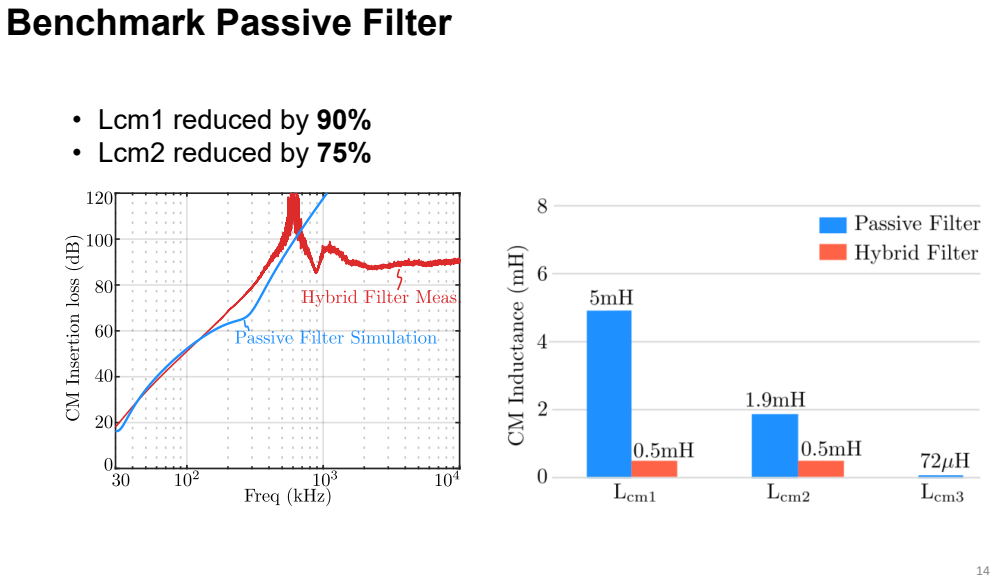
[picture p68: page 14]
• Lcm1 reduced by 90% • Lcm2 reduced by 75%

## Conductive Emission Measurement

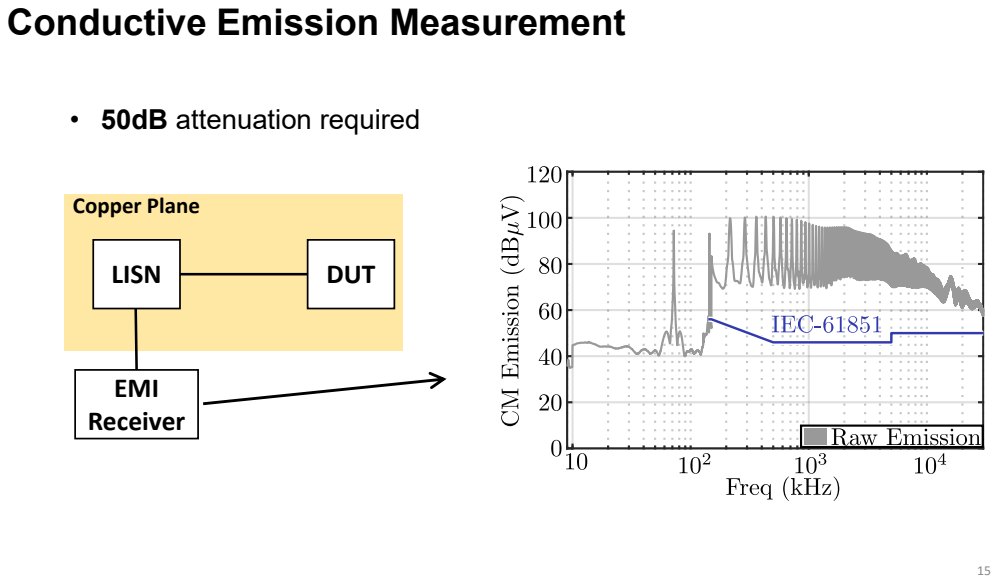
[picture p69: page 15]
LISN; DUT; EMI Receiver; Copper Plane; • 50dB attenuation required

## Conductive Emission Measurement

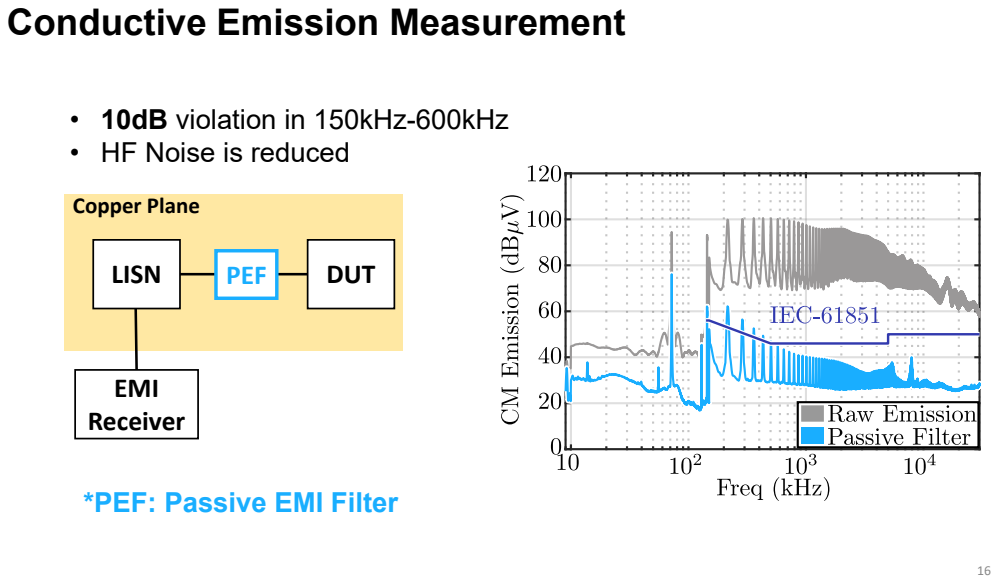
[picture p70: page 16]
LISN; DUT; EMI Receiver; PEF; Copper Plane

• 10dB violation in 150kHz-600kHz
• HF Noise is reduced

*PEF: Passive EMI Filter

## Conductive Emission Measurement

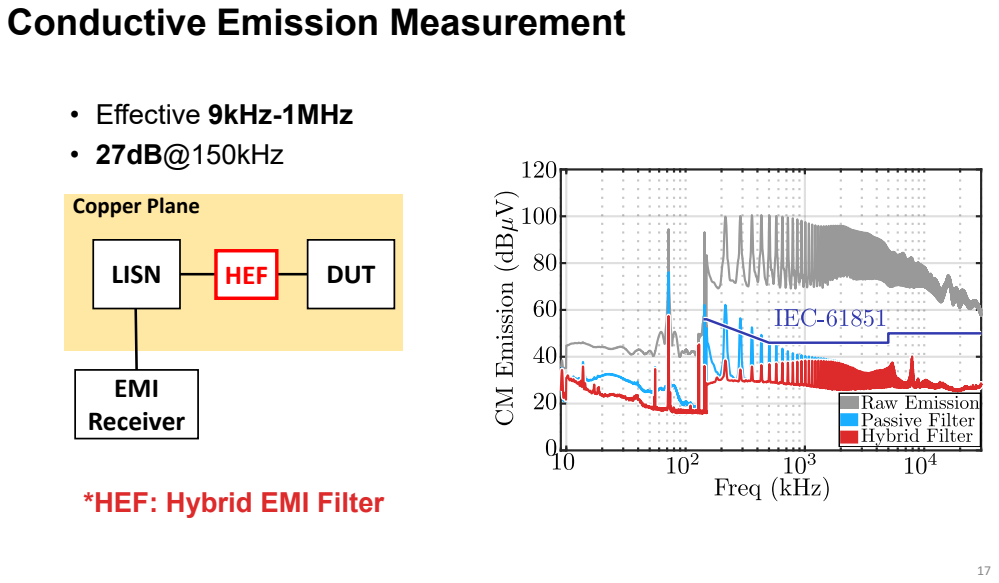
[picture p71: page 17]
LISN; DUT; EMI Receiver; HEF; Copper Plane; • Effective 9kHz-1MHz; • 27dB@150kHz

*HEF: Hybrid EMI Filter

## Conclusion

- Hybrid EMI Filter New Design Option
- Volume/Weight Reduction
- Higher Attenuation
- Higher Power Density

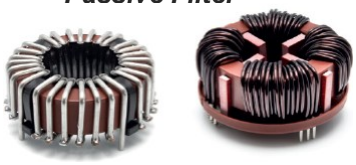
[picture p72: figure]

Hybrid Filter Passive Filter

https://vacuumschmelze.com/products/inductive-components-and-cores/amorphous-and-nanocrystalline-cores

## Active EMI Filter Design

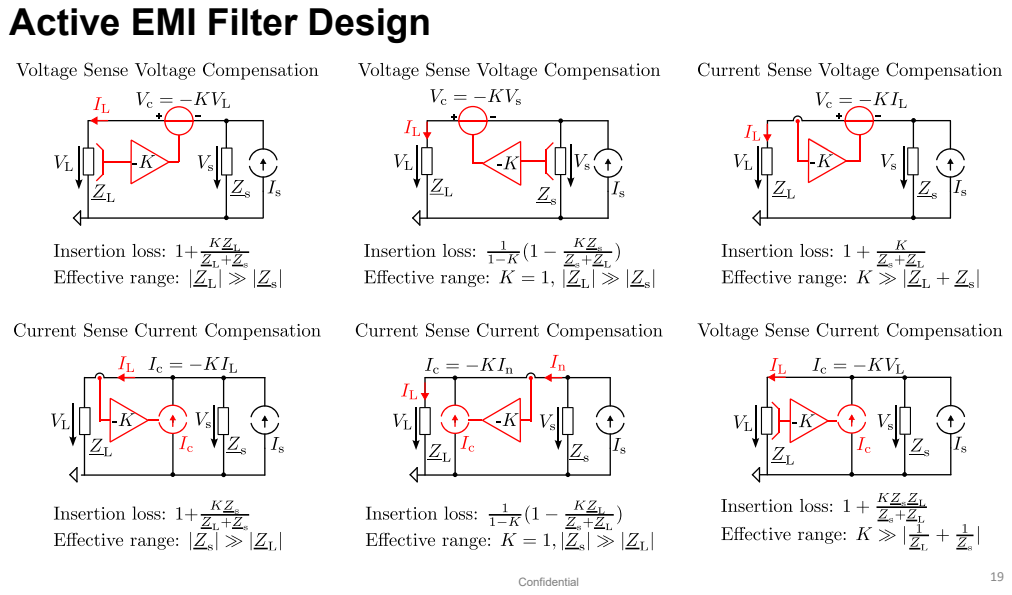
[picture p73: page 19]
Confidential

## Conclusion

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

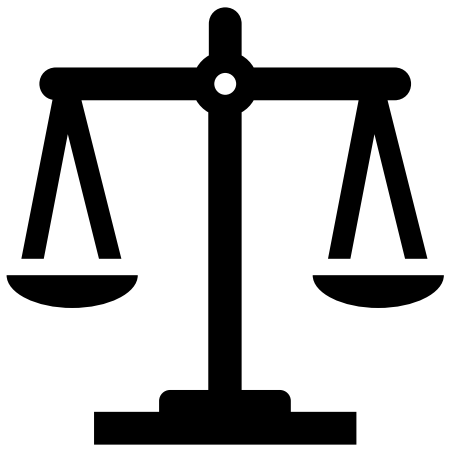
[picture p74: figure]
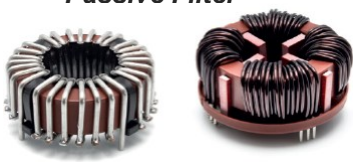
[picture p75: figure]

Hybrid Filter Passive Filter

## Insertion Loss Measurement

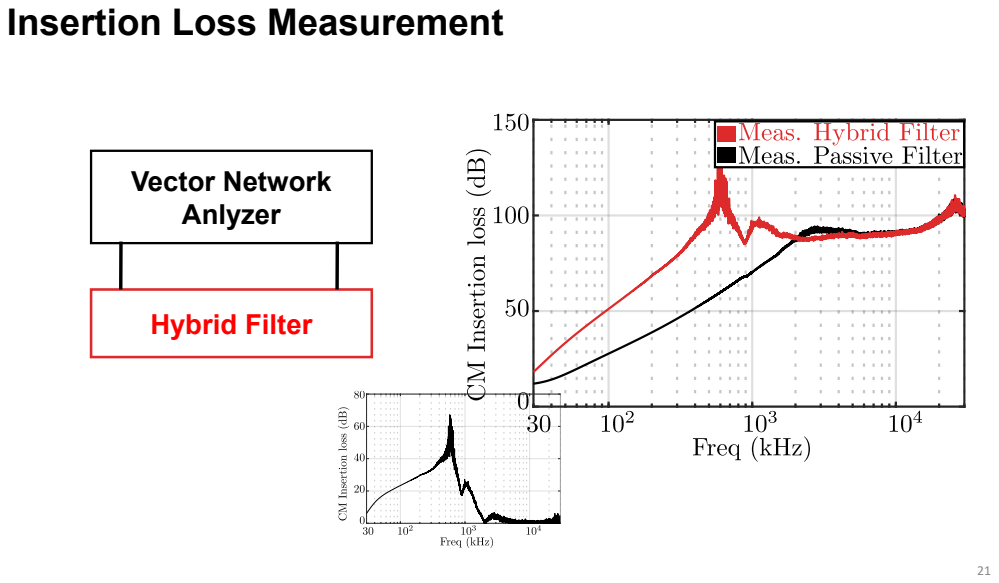
[picture p76: page 21]
Vector Network Anlyzer; Hybrid Filter
