wzh201998/ECCE_2026_Design-and-Implementation-of-A-Hybrid-EMI-Filter-for-11kW-OBC/Experiment/Insertion loss loop gain/Fit_Meas/CM_DM_Power_Splitter.asc

L1: ind2; {4*Lct}
L2: ind2; {Lct}
L3: ind2; {Lct}
L4: ind2; {4*Lct}
L5: ind2; {Lct}
L6: ind2; {Lct}
R1: res; 50
V1: voltage; ""; AC 1 0; Rser=50
Named nets: 0
k_Resp L1 L2  L3 1
k_excite L4 L5 L6 1
.net I(R1) V1
.ac dec 16001 9e3 30e6
.param Lct=1e-3
