wzh201998/ECCE_2026_Design-and-Implementation-of-A-Hybrid-EMI-Filter-for-11kW-OBC/Experiment/Insertion loss loop gain/Fit_Meas/Simulation_HEF_1phase.asc

C1: cap; {Cx3}; Rser={Cx3_ESR} Lser={Cx3_ESL}
C2: cap; {Cx1}; Rser={Cx1_ESR} Lser={Cx1_ESL}
C3: cap; {Cx2}; Rser={Cx2_ESR} Lser={Cx2_ESL}
C4: cap; {Cy2}; Rser={Cy2_ESR} Lser={Cy2_ESL}
C5: cap; {Cx3}; Rser={Cx3_ESR} Lser={Cx3_ESL}
C6: cap; {Cx1}; Rser={Cx1_ESR} Lser={Cx1_ESL}
C7: cap; {Cx1}; Rser={Cx1_ESR} Lser={Cx1_ESL}
C8: cap; {Cx2}; Rser={Cx2_ESR} Lser={Cx2_ESL}
C9: cap; {Cx2}; Rser={Cx2_ESR} Lser={Cx2_ESL}
C10: cap; {Cy1}; Rser={Cy1_ESR} Lser={Cy1_ESL}
C11: cap; {Cy1}; Rser={Cy1_ESR} Lser={Cy1_ESL}
C12: cap; {Cy1}; Rser={Cy1_ESR} Lser={Cy1_ESL}
C13: cap; {Cy2}; Rser={Cy1_ESR} Lser={Cy1_ESL}
C14: cap; {Cy2}; Rser={Cy1_ESR} Lser={Cy1_ESL}
C15: cap; {Cy2}; Rser={Cy1_ESR} Lser={Cy1_ESL}
C16: cap; {Cx3}; Rser={Cx3_ESR} Lser={Cx3_ESL}
C17: cap; {Cx3}; Rser={Cx3_ESR} Lser={Cx3_ESL}
C18: cap; {Cy2}; Rser={Cy2_ESR} Lser={Cy2_ESL}
C19: cap; {Cy2}; Rser={Cy2_ESR} Lser={Cy2_ESL}
C20: cap; {Cy2}; Rser={Cy2_ESR} Lser={Cy2_ESL}
C21: cap; {Cy2}; Rser={Cy2_ESR} Lser={Cy2_ESL}
C22: cap; {Cy2}; Rser={Cy2_ESR} Lser={Cy2_ESL}
C23: cap; {Cx3}; Rser={Cx3_ESR} Lser={Cx3_ESL}
C24: cap; {Cx3}; Rser={Cx3_ESR} Lser={Cx3_ESL}
C25: cap; {Cx3}; Rser={Cx3_ESR} Lser={Cx3_ESL}
C26: cap; {Cx3}; Rser={Cx3_ESR} Lser={Cx3_ESL}
C27: cap; {Cx3}; Rser={Cx3_ESR} Lser={Cx3_ESL}
C28: cap; {Cy2}; Rser={Cy1_ESR} Lser={Cy1_ESL}
C29: cap; {Cy2}; Rser={Cy1_ESR} Lser={Cy1_ESL}
L1: ind2; {Ldm}; Rser={Ldm_ESR} Rpar={Ldm_EPR} Cpar={Ldm_EPC}
L2: ind2; {Lcm}; Rser={Lcm_ESR} Rpar={Lcm_EPR} Cpar={Lcm_EPC}
L3: ind2; {Lcm2}; Rser={Lcm2_ESR} Rpar={Lcm2_EPR} Cpar={Lcm2_EPC}
L4: ind2; {Ldm}; Rser={Ldm_ESR} Rpar={Ldm_EPR} Cpar={Ldm_EPC}
L5: ind2; {Ldm}; Rser={Ldm_ESR} Rpar={Ldm_EPR} Cpar={Ldm_EPC}
L6: ind2; {Ldm}; Rser={Ldm_ESR} Rpar={Ldm_EPR} Cpar={Ldm_EPC}
L7: ind2; {Ldm}; Rser={Ldm_ESR} Rpar={Ldm_EPR} Cpar={Ldm_EPC}
L8: ind2; {Ldm}; Rser={Ldm_ESR} Rpar={Ldm_EPR} Cpar={Ldm_EPC}
L11: ind2; {Lcm}; Rser={Lcm_ESR} Rpar={Lcm_EPR} Cpar={Lcm_EPC}
L12: ind2; {Lcm2}; Rser={Lcm2_ESR} Rpar={Lcm2_EPR} Cpar={Lcm2_EPC}
L15: ind2; 2.8µ
L16: ind2; 2.8µ
L19: ind2; 473µ; Rpar=10e3 Cpar=1e-12
R1: res; 50
R2: res; 0.1
R3: res; 39
R4: res; 740
R5: res; 740
R6: res; 800e3
U1: THS4631
V1: voltage; ""; AC 1 0; Rser=50
V2: voltage; 15
V3: voltage; 15
Named nets: 0, Vcc, Vee
.param Cy2=4.7n Cy2_ESR=0.1 Cy2_ESL=10n
.param Cx1=2.2u Cx1_ESR=0.1 Cx1_ESL=20n
.param Cy1=1.5n Cy1_ESR=0.1 Cy1_ESL=10n
.param Cx2=1.5u Cx2_ESR=0.1 Cx2_ESL=20n
.param Cx3=100n Cx3_ESR=0.1 Cx3_ESL=20n
.param Ldm=24u Ldm_ESR=0.1 Ldm_EPC=8p Ldm_EPR=12.38e3
.param Lcm=1.2m Lcm_ESR=0.1 Lcm_EPC=10p Lcm_EPR=2e3
.param Lcm2=1.2m Lcm2_ESR=0.1 Lcm2_EPC=20p Lcm2_EPR=20e3
kdm1 L1 L4 -1
kdm2 L5 L6 -1
kdm3 L7 L8 -1
kcm1 L2  L11 0.9
kcm2 L3 L12 0.9
.net I(R1) V1
.ac dec 16001 9e3 30e6
kct L15 L16 L19 0.9
