wzh201998/ECCE_2026_Design-and-Implementation-of-A-Hybrid-EMI-Filter-for-11kW-OBC/Experiment/Insertion loss loop gain/Fit_Meas/Simulation_PEF_1phase_DM.asc

C1: cap; {Cx3}; Rser={Cx3_ESR} Lser={Cx3_ESL}
C2: cap; {Cx1}; Rser={Cx1_ESR} Lser={Cx1_ESL}
C3: cap; {Cx2}; Rser={Cx2_ESR} Lser={Cx2_ESL}
C4: cap; {Cy2}; Rser={Cy2_ESR} Lser={Cy2_ESL}
C5: cap; {Cx3}; Rser={Cx3_ESR} Lser={Cx3_ESL}
C6: cap; {Cx1}; Rser={Cx1_ESR} Lser={Cx1_ESL}
C7: cap; {Cx1}; Rser={Cx1_ESR} Lser={Cx1_ESL}
C8: cap; {Cx2}; Rser={Cx2_ESR} Lser={Cx2_ESL}
C9: cap; {Cx2}; Rser={Cx2_ESR} Lser={Cx2_ESL}
C10: cap; {Cy1}; Rser={Cy1_ESR} Lser={Cy1_ESL}
C11: cap; {Cx3}; Rser={Cx3_ESR} Lser={Cx3_ESL}
C13: cap; {Cy1}; Rser={Cy1_ESR} Lser={Cy1_ESL}
C16: cap; {Cx3}; Rser={Cx3_ESR} Lser={Cx3_ESL}
C17: cap; {Cx3}; Rser={Cx3_ESR} Lser={Cx3_ESL}
C18: cap; {Cy2}; Rser={Cy2_ESR} Lser={Cy2_ESL}
C19: cap; {Cy2}; Rser={Cy2_ESR} Lser={Cy2_ESL}
C20: cap; {Cy2}; Rser={Cy2_ESR} Lser={Cy2_ESL}
C21: cap; {Cy2}; Rser={Cy2_ESR} Lser={Cy2_ESL}
C22: cap; {Cy2}; Rser={Cy2_ESR} Lser={Cy2_ESL}
C23: cap; {Cx3}; Rser={Cx3_ESR} Lser={Cx3_ESL}
C24: cap; {Cx3}; Rser={Cx3_ESR} Lser={Cx3_ESL}
C25: cap; {Cx3}; Rser={Cx3_ESR} Lser={Cx3_ESL}
C26: cap; {Cx3}; Rser={Cx3_ESR} Lser={Cx3_ESL}
C27: cap; {Cx3}; Rser={Cx3_ESR} Lser={Cx3_ESL}
L1: ind2; {Ldm}; Rser={Ldm_ESR} Rpar={Ldm_EPR} Cpar={Ldm_EPC}
L2: ind2; {Lcm}; Rser={Lcm_ESR} Rpar={Lcm_EPR} Cpar={Lcm_EPC}
L3: ind2; {Lcm2}; Rser={Lcm2_ESR} Rpar={Lcm2_EPR} Cpar={Lcm2_EPC}
L4: ind2; {Ldm}; Rser={Ldm_ESR} Rpar={Ldm_EPR} Cpar={Ldm_EPC}
L5: ind2; {Ldm}; Rser={Ldm_ESR} Rpar={Ldm_EPR} Cpar={Ldm_EPC}
L6: ind2; {Ldm}; Rser={Ldm_ESR} Rpar={Ldm_EPR} Cpar={Ldm_EPC}
L7: ind2; {Ldm}; Rser={Ldm_ESR} Rpar={Ldm_EPR} Cpar={Ldm_EPC}
L8: ind2; {Ldm}; Rser={Ldm_ESR} Rpar={Ldm_EPR} Cpar={Ldm_EPC}
L9: ind2; {4*Lct}
L10: ind2; {Lct}
L11: ind2; {Lcm}; Rser={Lcm_ESR} Rpar={Lcm_EPR} Cpar={Lcm_EPC}
L12: ind2; {Lcm2}; Rser={Lcm2_ESR} Rpar={Lcm2_EPR} Cpar={Lcm2_EPC}
L13: ind2; {Lct}
L14: ind2; {4*Lct}
L15: ind2; {Lct}
L16: ind2; {Lct}
L17: ind2; 10e-9
L18: ind2; 10e-9
L19: ind2; 10e-9
R1: res; 50
V1: voltage; ""; AC 1 0; Rser=50
Named nets: 0
.param Cy2=4.7e-9 Cy2_ESR=0.1 Cy2_ESL=10e-9
.param Cy1=4.7e-9 Cy1_ESR=0.1 Cy1_ESL=10e-9
.param Cx3=100n Cx3_ESR=0.6 Cx3_ESL=20n
.param Ldm=25u Ldm_ESR=0.1 Ldm_EPC=30p Ldm_EPR=2e3
kdm1 L1 L4 -0.95
kdm2 L5 L6 -0.95
kdm3 L7 L8 -0.95
kcm1 L2  L11 1
kcm2 L3 L12 1
.net I(R1) V1
.ac dec 16001 9e3 30e6
k_excite L9 L10 L13 1
k_Resp L14 L15 L16 1
.param Lcm=300u Lcm_ESR=0.1 Lcm_EPC=30p Lcm_EPR=2e3
.param Lcm2=1.2e-3 Lcm2_ESR=0.1 Lcm2_EPC=20p Lcm2_EPR=2e3
.param Lct=1e-3
.param Cx2=1.5u Cx2_ESR=0.6 Cx2_ESL=50n
.param Cx1=2.2u Cx1_ESR=0.2 Cx1_ESL=500n
Kmutual L17 L18 L19 0.1
