wzh201998/ECCE_2026_Design-and-Implementation-of-A-Hybrid-EMI-Filter-for-11kW-OBC/Experiment/Insertion loss loop gain/op model/LM7171_Sim_model.asc

I1: current; ""; AC 1 0
R1: res; 770
R2: res; 340e3
U1: LM7171
V1: voltage; 15
V2: voltage; 15
V3: voltage; ""; AC 1 0
Named nets: 0, Vcc, Vee, out
.ac dec 80001 9e3 30e6
.ac dec 80001 9e3 800e6
